NattyBoppy/MDDSTROKE/docs/design/hand_unit_layout.html

Stroke hand exoskeleton · V1 layout

# Hand Unit Layout

Where the 4 flex sensors and the 2 MG996R servos go. The flex sensors are the same in both designs. The servos either sit on the back of the hand (design A) or in a box on the table, pulling the lines through tubes (design B).

PickDesign B for V1. It keeps about 150 g of motors off a weak hand and has room for the bigger spool the MG996R needs. It also gives you a kill switch within reach, and it matches the two-piece setup your prof said he'd accept if justified.

Loading 3D model…

Design B · table-top unitDrag to rotate · scroll or pinch to zoom

Design

A · Servos on hand B · Table-top unit

Servo rotation

120° datasheet 180° wide pulse

Flex sensor length

2.2 inch 4.5 inch

TPU clamps Flex sensor Fishing line Elastic strap MG996R Coil sheath

Flex sensors · side view of one finger

## One sensor per finger, under the line, free to slide

Every clamp now has a flat 7.2 × 1.0 mm slot just above the finger and below the two line channels. The updated STLs on the clamp page include it.

Why this way

## The most workable mount

- Fix one end only. The back of the finger gets about 40 mm longer when you make a fist, but the sensor doesn't stretch. If both ends were fixed it would buckle or tear. Clamp the pin end on the plate and let the rest slide through the clamps.
- Don't bend the pin end. The makers warn the base of the sensor cracks if it flexes. The clamp on the plate keeps the first 15 mm or so dead flat.
- Closest to the finger. The slot sits under the line and strap, so the sensor follows the finger's curve and is protected from being pulled or snagged.
- Length matters. A 2.2" sensor reads mostly the big knuckle (MCP), which is the main joint in a clenched fist. A 4.5" sensor covers all three joints. Slide a 4.5" further back on the pinky so it doesn't stick out past the fingertip.
- Works with both designs. The 4 sensor cables run back along the plate to the controller.

The two motor designs

## Servos on the hand, or in a box beside it

Later, if portable matters

### A · Servos on the back of the hand

The finger servo lies on its side on a plate over the knuckles, with the spool beside it. The thumb servo doesn't fit beside it, so it sits behind, over the wrist, on a cuff. The ESP32 and battery go in a forearm pack.

Good

- No tubes, so no friction loss in the line
- Patient can walk around with it
- Simple line path

Problems

- About 170–200 g on a weak hand, as much as a phone
- Spool stands about 35–50 mm off the hand
- Spills over the wrist
- Motor noise and heat on the skin
- High-current servo wires and a battery on the arm

Recommended for V1

### B · Table-top unit with sheaths

Both servos, their spools, the ESP32-S3 DevKit and the power supply sit in a box on the table. The hand wears only the clamps, the sensors and a light plate. On the plate, the 4 finger lines meet at the balance bar (whiffletree), and the sheath ends are held in a stop block. Each line then runs to the box inside a coil sheath (Bowden cable) with a PTFE liner, like SNU's Exo-Glove.

Good

- Only about 30–40 g on the hand
- Low profile, under 15 mm
- Room for a big spool, or a stronger motor later
- Kill switch and power on the table
- Same idea as SNU's Exo-Glove

Problems

- Sheaths lose about 20–40% of the pull to friction, more with tight bends
- Tethered to the table
- Sheath ends need solid stops at both ends

What matters | A · on hand | B · table-top
Weight on the hand | ≈ 170–200 g | ≈ 30–40 g
Height above the hand | — | < 15 mm
Pull reaching the finger | All of it | About 60–80%, depending on sheath bends
Fits a clenched, spastic hand | Bulky plate is harder to strap on | Light plate, easy to strap on
Safety | Servos and battery on the body | Kill switch and supply on the table
Portable | Yes | No, it's tethered
Upgrade path | Stuck with small motors | Bigger motors fit in the box
Matches prof's brief | Portable, but heavy | Two-piece is accepted if justified

Numbers · one MG996R pulling all 4 fingers

## Spool size and pull

Going from a full fist to straight, each finger's line has to travel about 40–47 mm. That's my estimate from your finger sizes and normal joint ranges, so measure it on the test hand with a piece of string. A servo can only reel in line equal to spool radius × rotation, so less rotation needs a bigger spool, and a bigger spool pulls more weakly.

Servo rotation | Spool radius for 47 mm | Line pull at stall, 6 V | Per finger at stall | Per finger, safe running (≈ half)

One servo for 4 fingers is tight

At 120°, each finger gets only about 6 N in steady use, before any sheath losses. That may not open a strongly spastic hand. Before building the box, hang a luggage scale on one finger of the test hand and measure the pull it needs. If it's more than this, two fixes are possible. One is to set the servo to 180° by testing it with a 500–2500 µs pulse range. The other is to use both servos for the fingers (index + middle on one, ring + pinky on the other) and add the thumb with a third motor in V2.

Wiring · ESP32-S3 DevKit (pin plan from the repo)

## Pins and power

Part | GPIO | Notes
Flex sensors (index, middle, ring, little) | 4, 6, 7, 8 | 3V3 → flex → GPIO → 47k → GND. Pick the fixed resistor close to the sensor's own resistance (measure it with a multimeter). All on ADC1, which keeps working while Wi-Fi or Bluetooth is on. Thumb flex, later: GPIO 9.
EMG A (extensor), EMG B (flexor, later) | 1, 2 | Always through the 1/3 divider (3 × 47k). The red EMG board can output up to about 9 V.
Servo 1 (4 fingers), servo 2 (thumb) | 5, 16 | Signal wire only.
Kill switch | servo power line | The switch should cut servo power directly, not just tell the code to stop. The website STOP button (and the Space key) still sends s.
Servo power | Bench supply, adjustable 6.0 V | Set the current limit. Each MG996R can draw about 2.5 A when it stalls, so two need 5 A or more. Never power the servos from the ESP32. Join the grounds, and put a 470–1000 µF capacitor across the servo supply.
