NattyBoppy/MDDSTROKE/docs/concepts/A_c_clip_tunnels.png

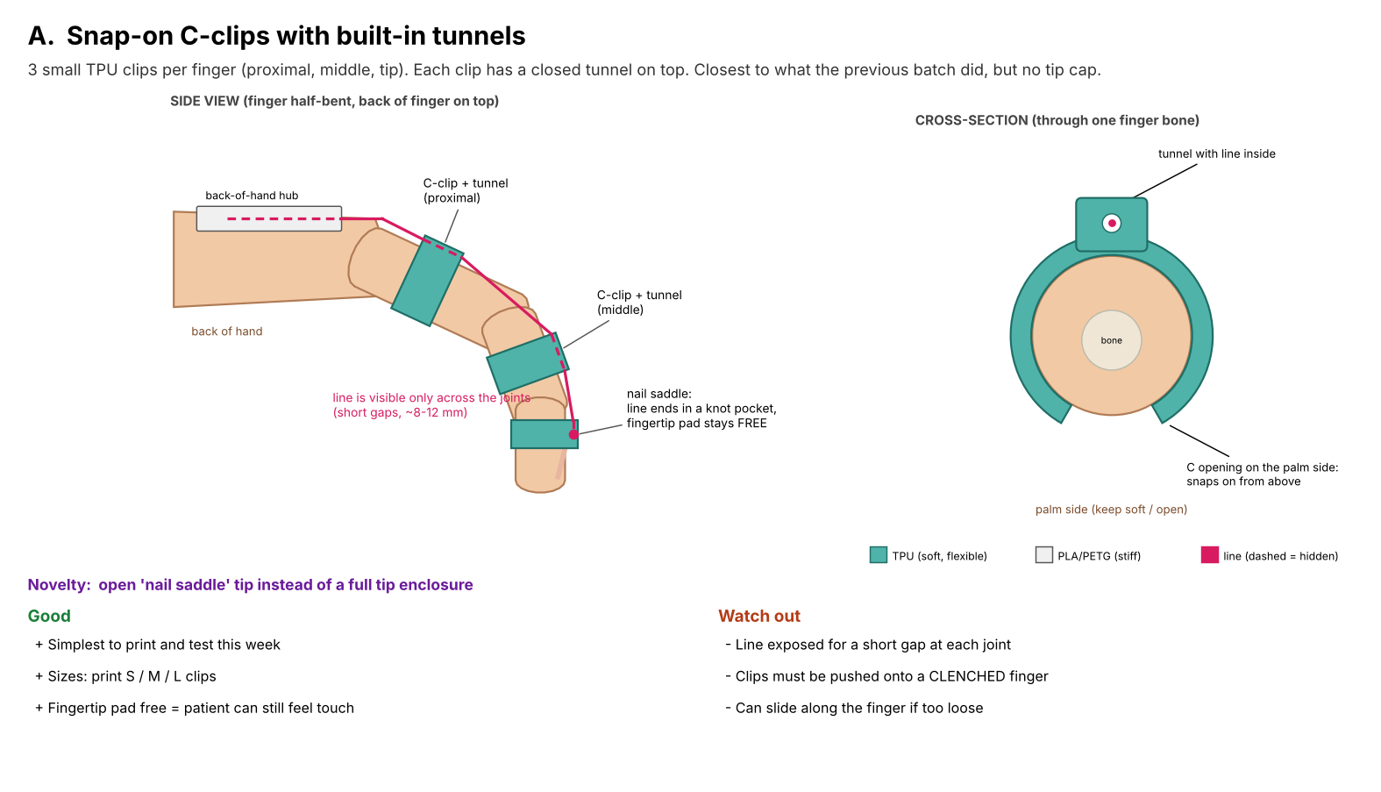
docs/concepts/A_c_clip_tunnels.png
