NattyBoppy/MDDSTROKE/docs/concepts/B_armadillo_scales.png

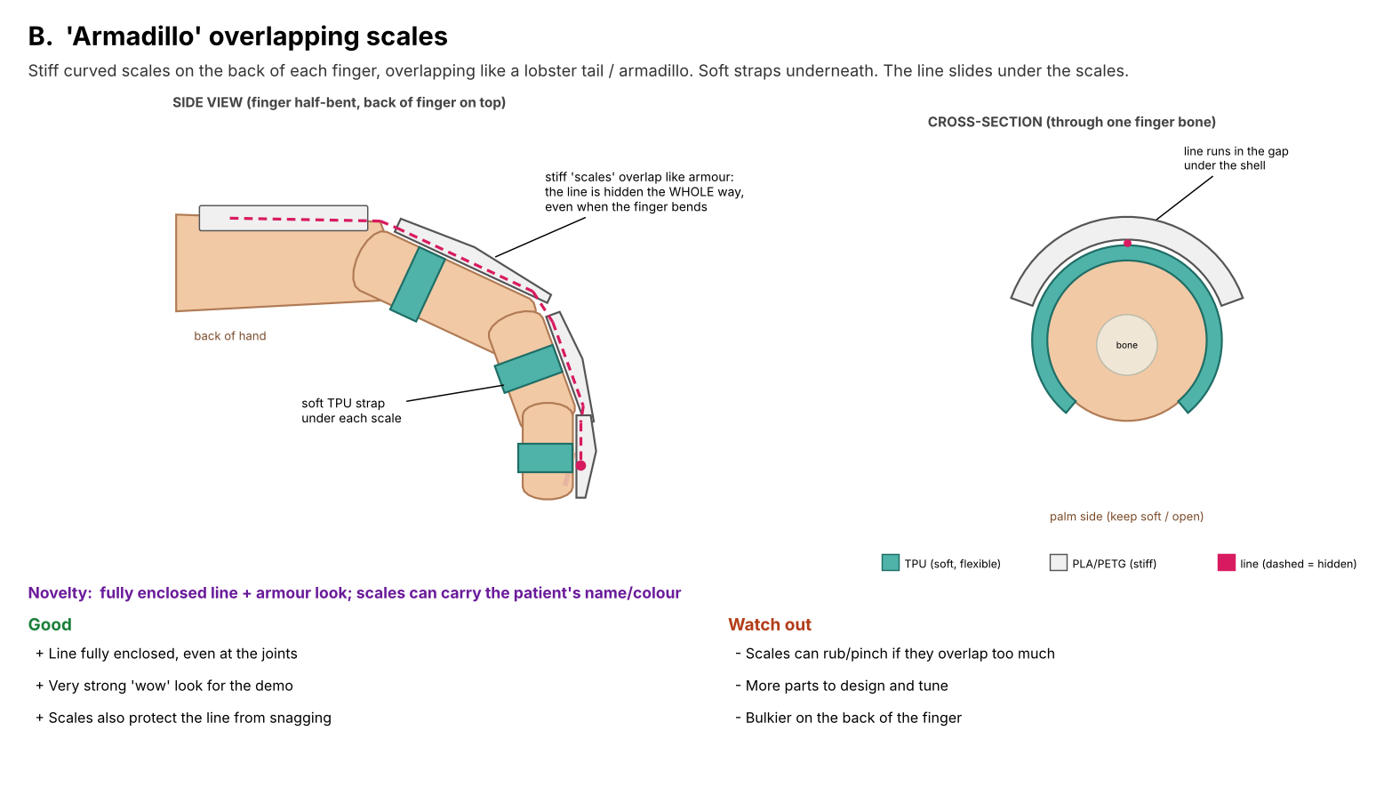
docs/concepts/B_armadillo_scales.png
