NattyBoppy/MDDSTROKE/docs/concepts/C_tpu_bellows_spine.png

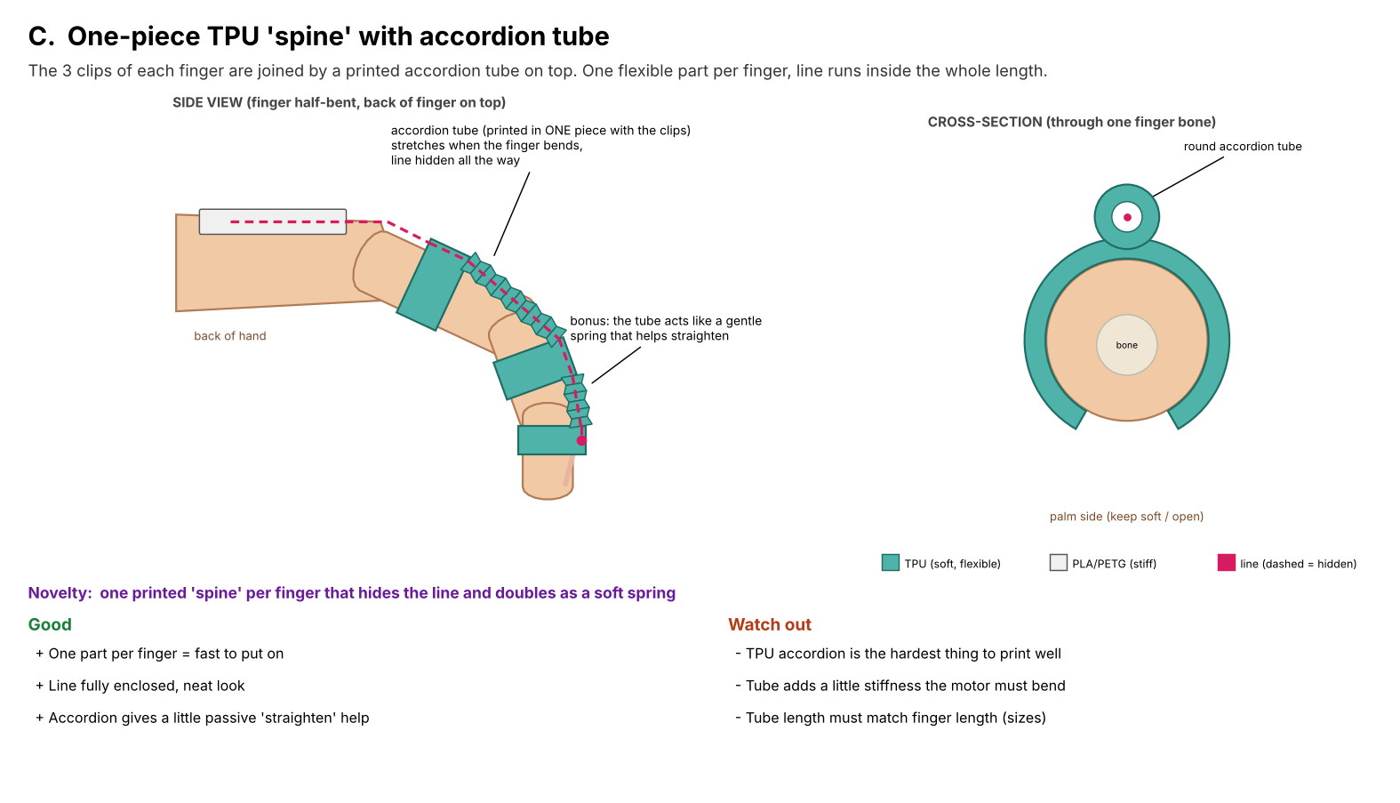
docs/concepts/C_tpu_bellows_spine.png
