NattyBoppy/MDDSTROKE/docs/concepts/D_open_tip_glove.png

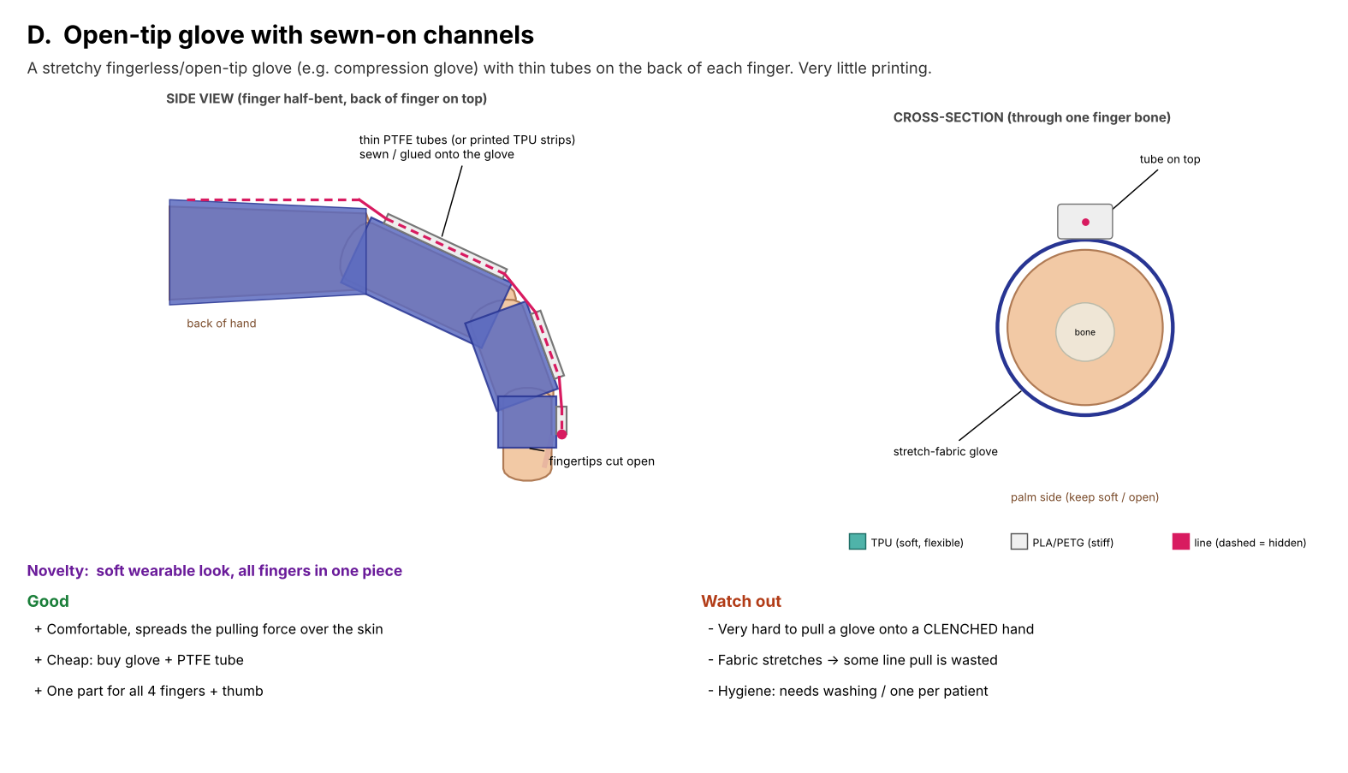
docs/concepts/D_open_tip_glove.png
