NattyBoppy/MDDSTROKE/docs/concepts/E_wrap_strap_clamp.png

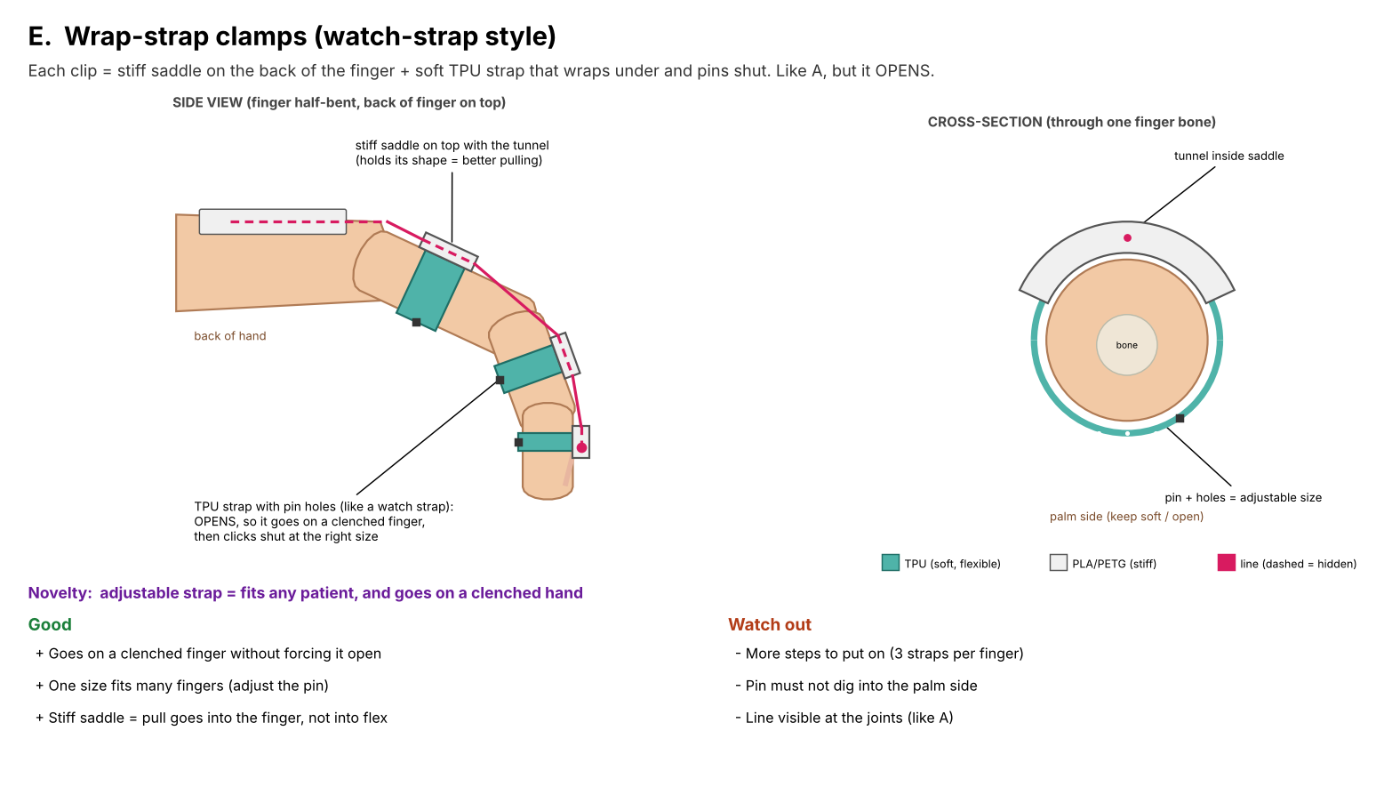
docs/concepts/E_wrap_strap_clamp.png
