NattyBoppy/MDDSTROKE/docs/concepts/glove_concepts.png

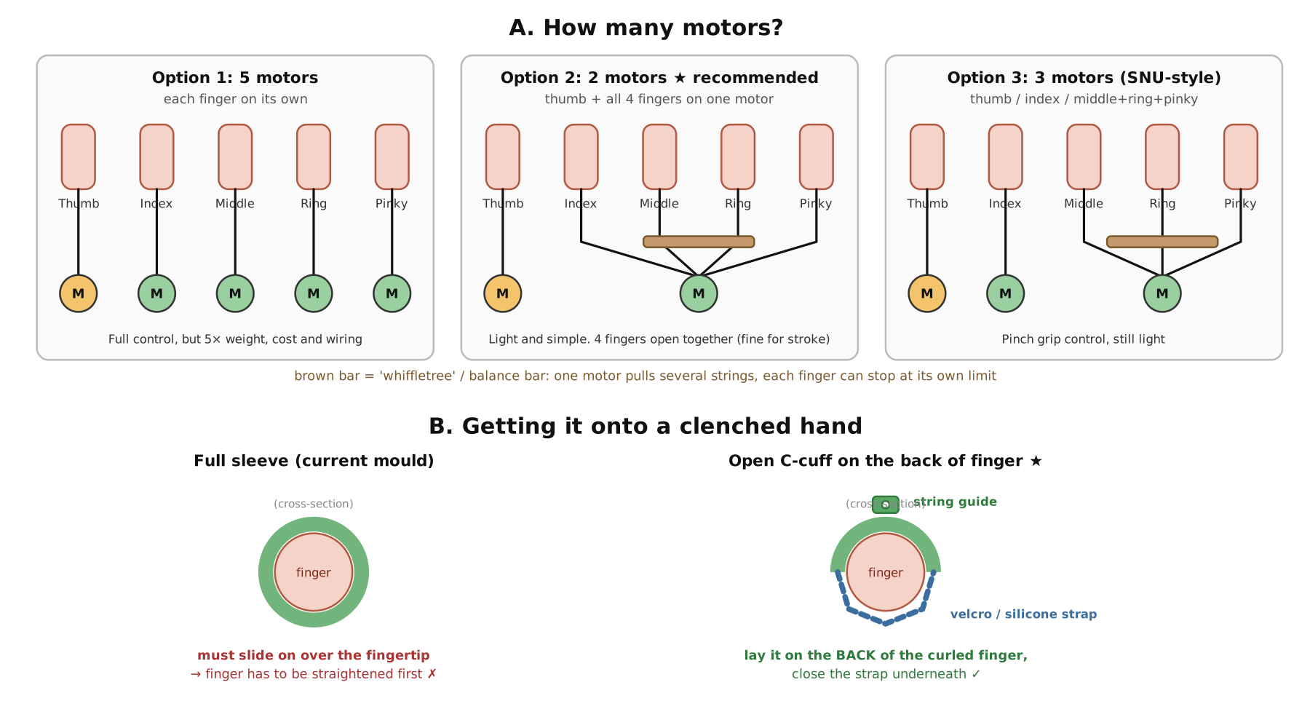
docs/concepts/glove_concepts.png
