NattyBoppy/MDDSTROKE/docs/concepts/table_unit_layout.png

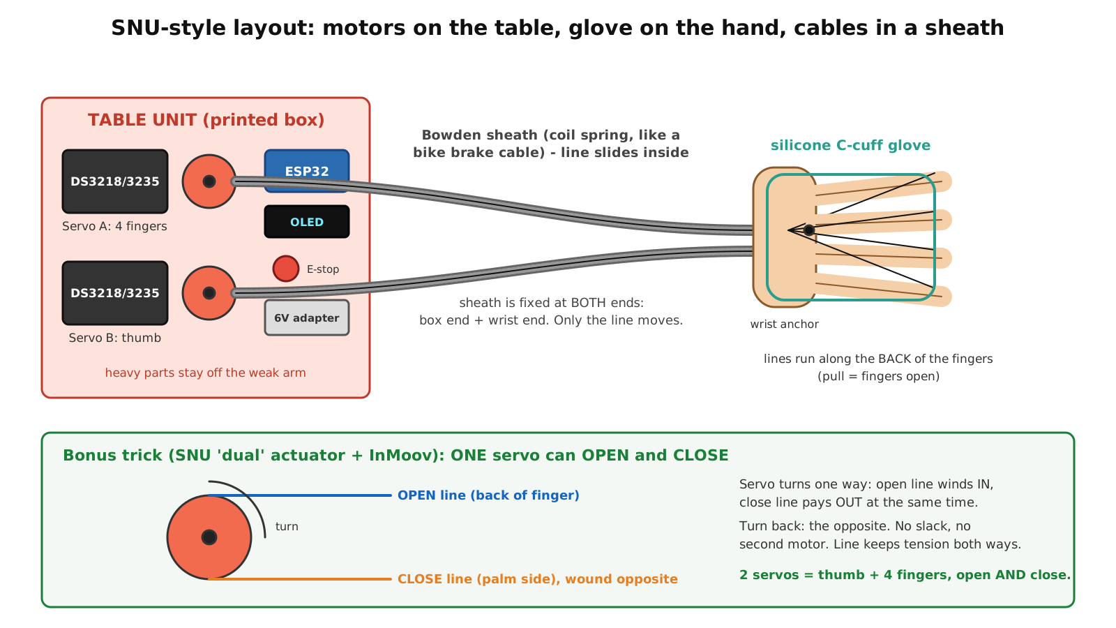
docs/concepts/table_unit_layout.png
