NattyBoppy/MDDSTROKE/docs/concepts/whiffletree.png

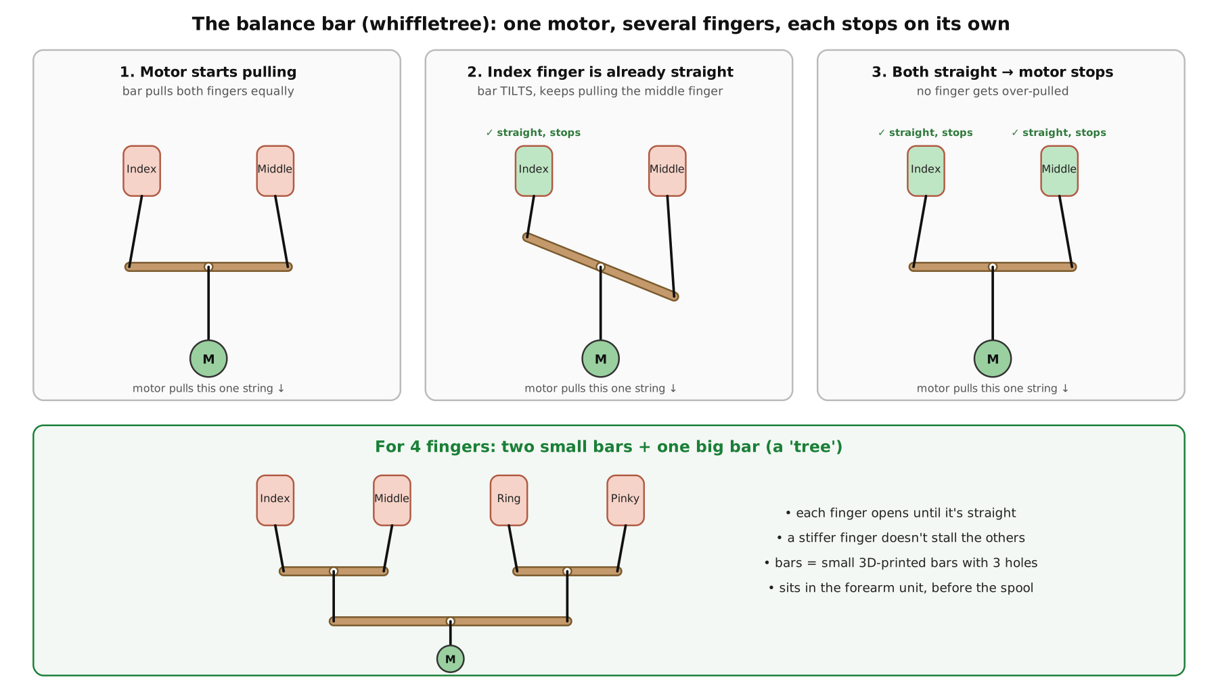
docs/concepts/whiffletree.png
