NattyBoppy/MDDSTROKE/docs/previews/anchors_snapin.png

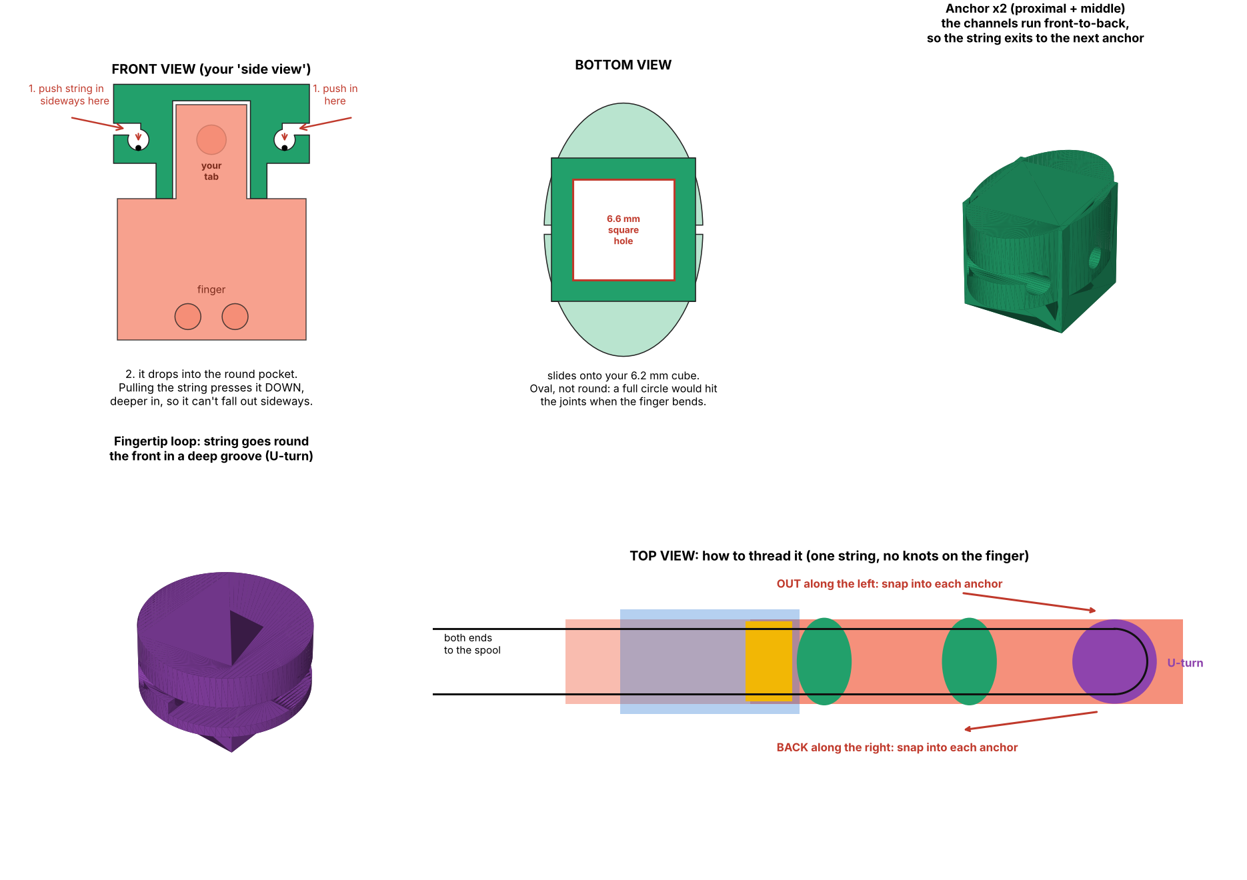
docs/previews/anchors_snapin.png
