NattyBoppy/MDDSTROKE/docs/previews/finger_clamps/tip_clamp_nose_v8.png

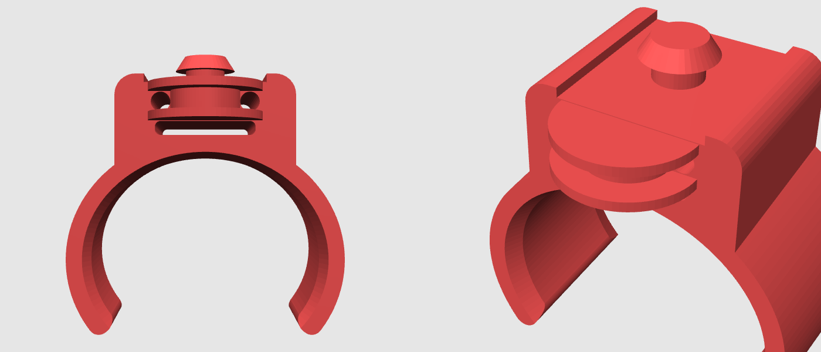
docs/previews/finger_clamps/tip_clamp_nose_v8.png
