NattyBoppy/MDDSTROKE/docs/previews/hand_mount_on_hand.png

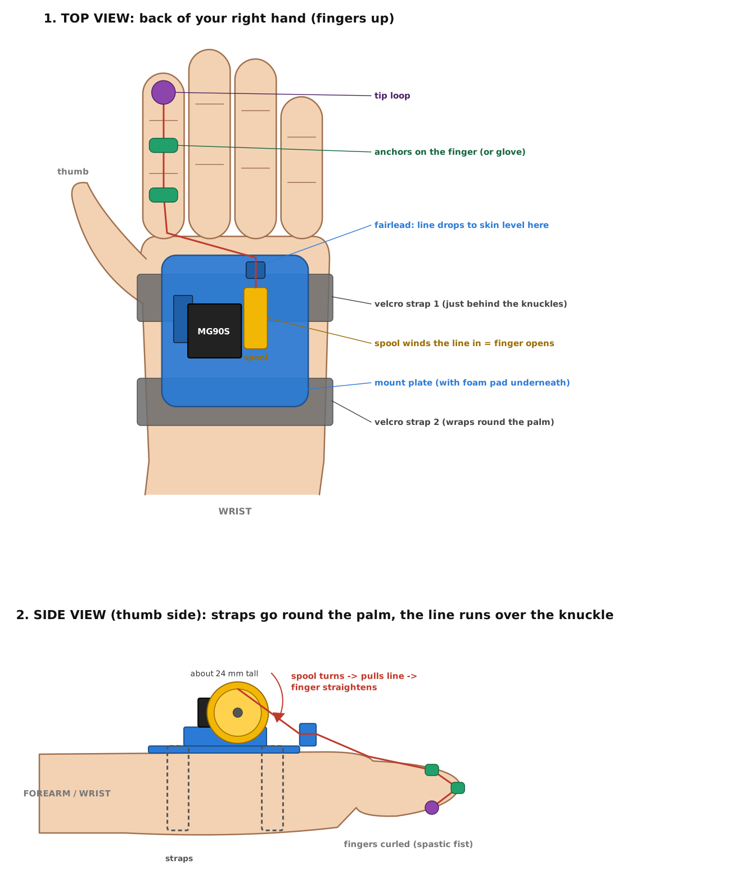
docs/previews/hand_mount_on_hand.png
