NattyBoppy/MDDSTROKE/docs/previews/knuckle_closeup.png

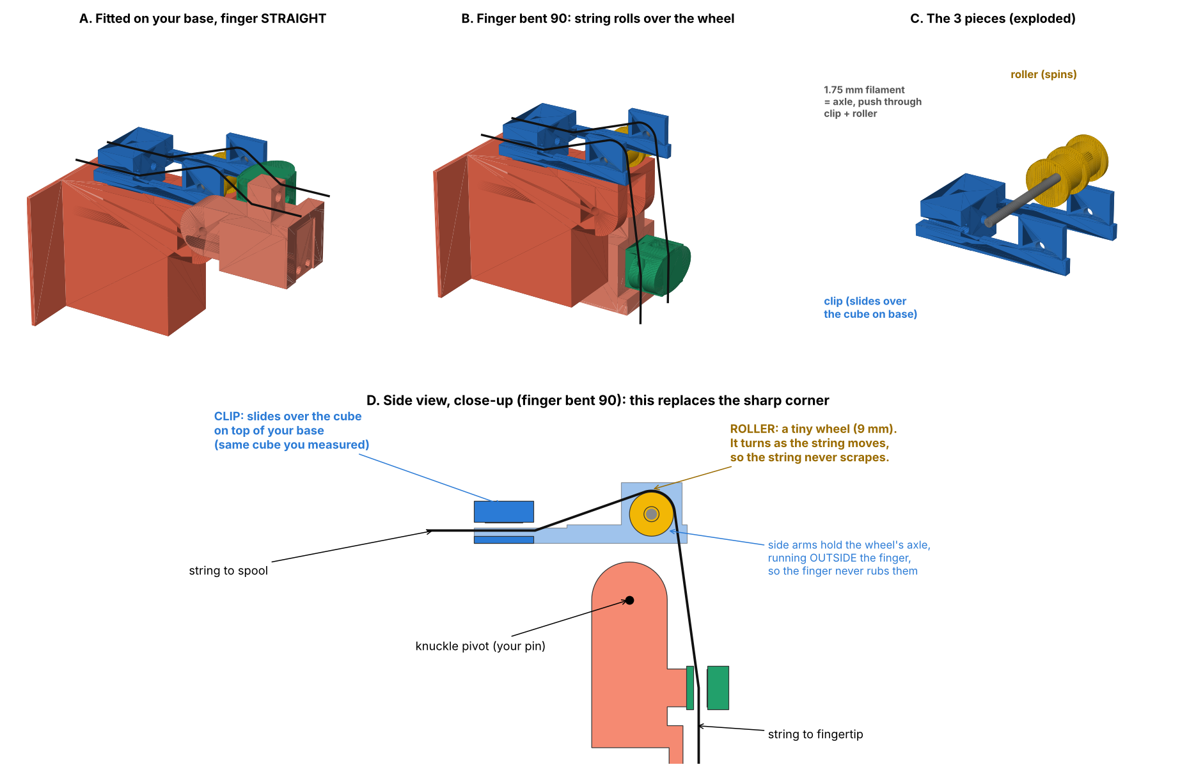
docs/previews/knuckle_closeup.png
