NattyBoppy/MDDSTROKE/docs/previews/spool_v4_preview.png

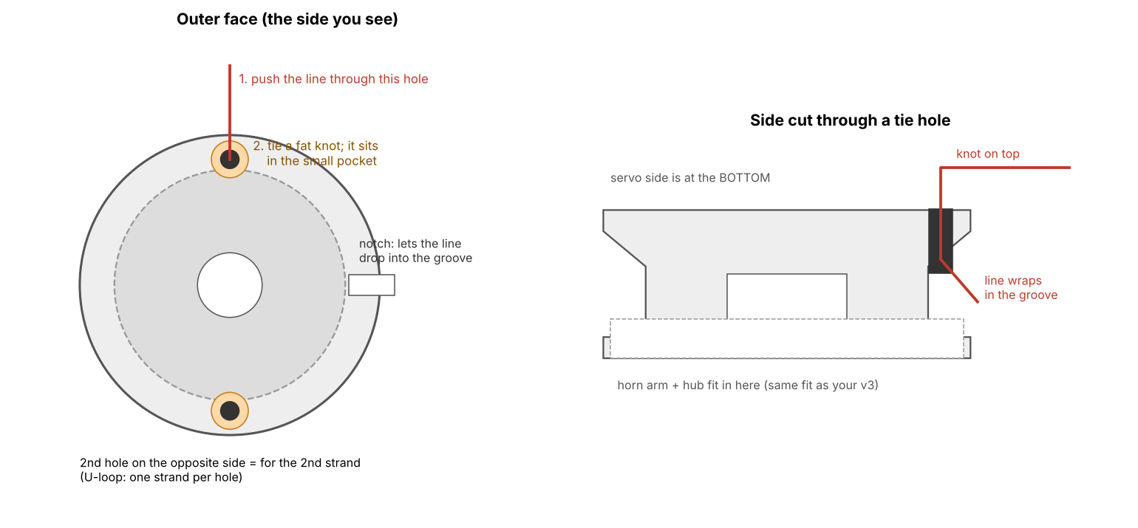
docs/previews/spool_v4_preview.png
