NattyBoppy/MDDSTROKE/docs/screenshots/desktop.png

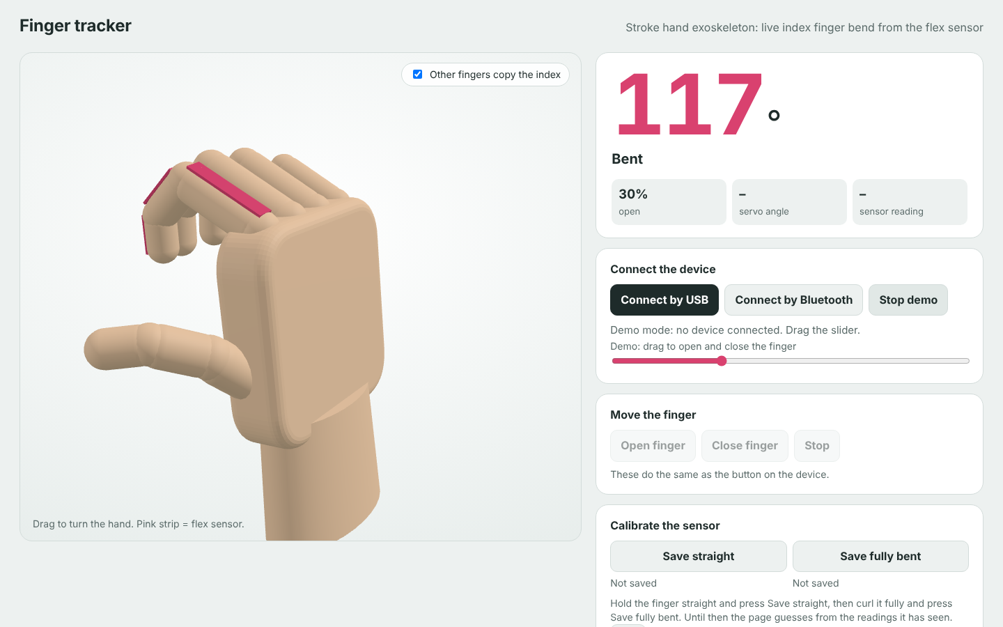
docs/screenshots/desktop.png
