NattyBoppy/MDDSTROKE/docs/screenshots/phone.png

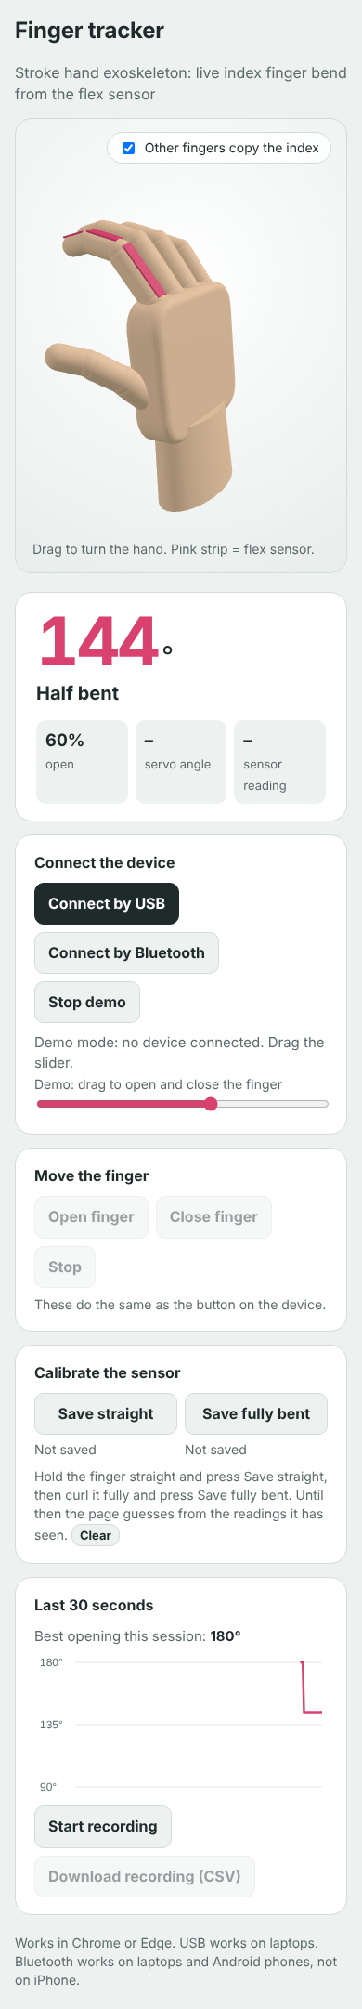
docs/screenshots/phone.png
