NattyBoppy/MDDSTROKE/docs/screenshots/v2_blocked.png

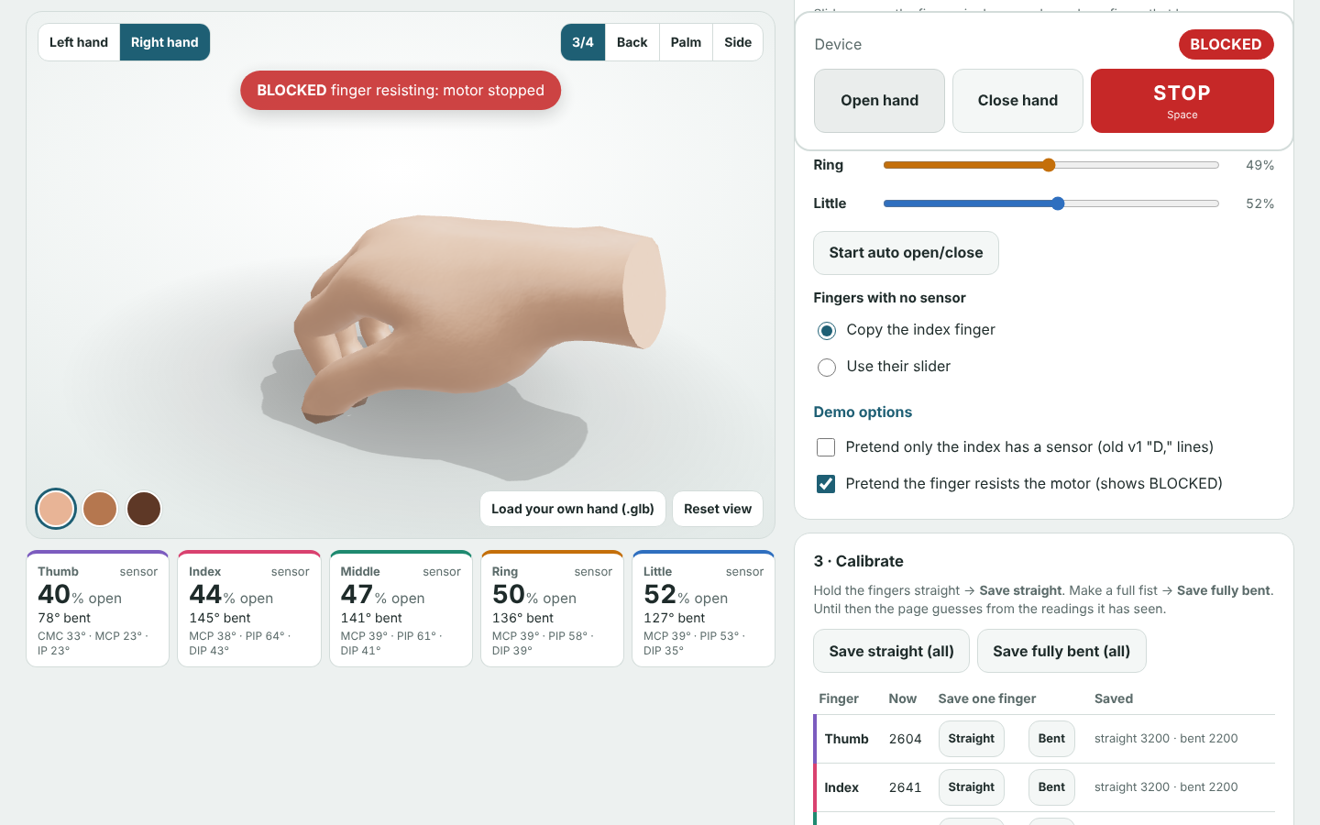
docs/screenshots/v2_blocked.png
