NattyBoppy/MDDSTROKE/docs/screenshots/v2_desktop_dark.png

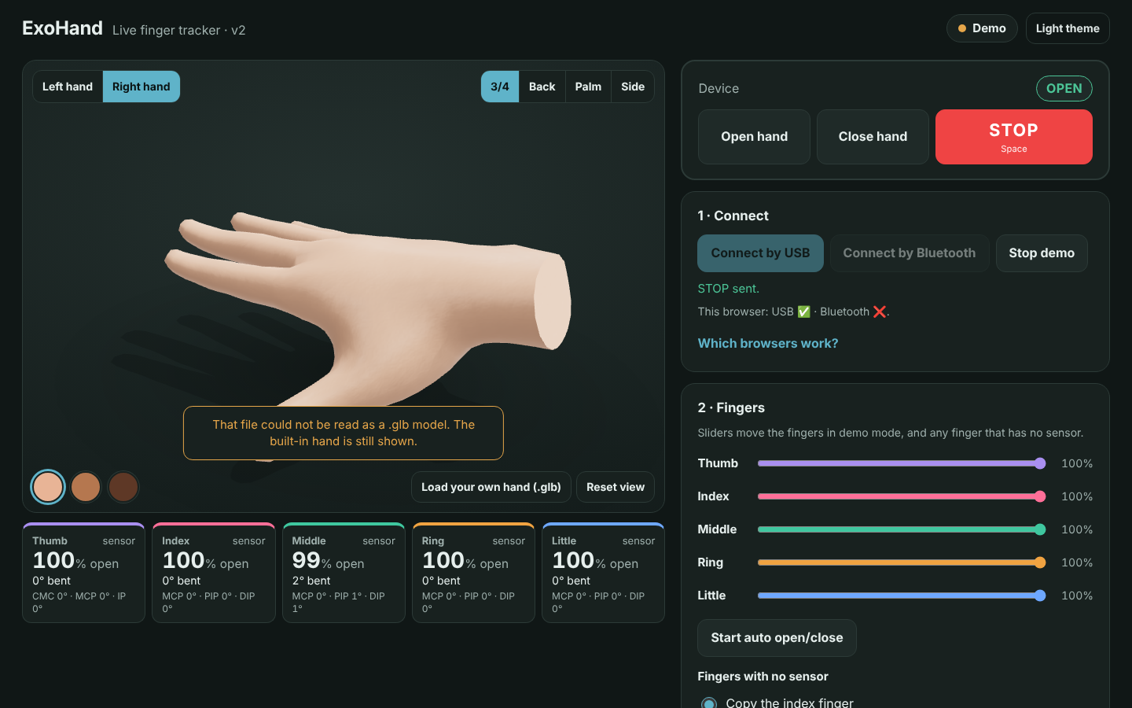
docs/screenshots/v2_desktop_dark.png
