NattyBoppy/MDDSTROKE/docs/screenshots/v2_desktop_open.png

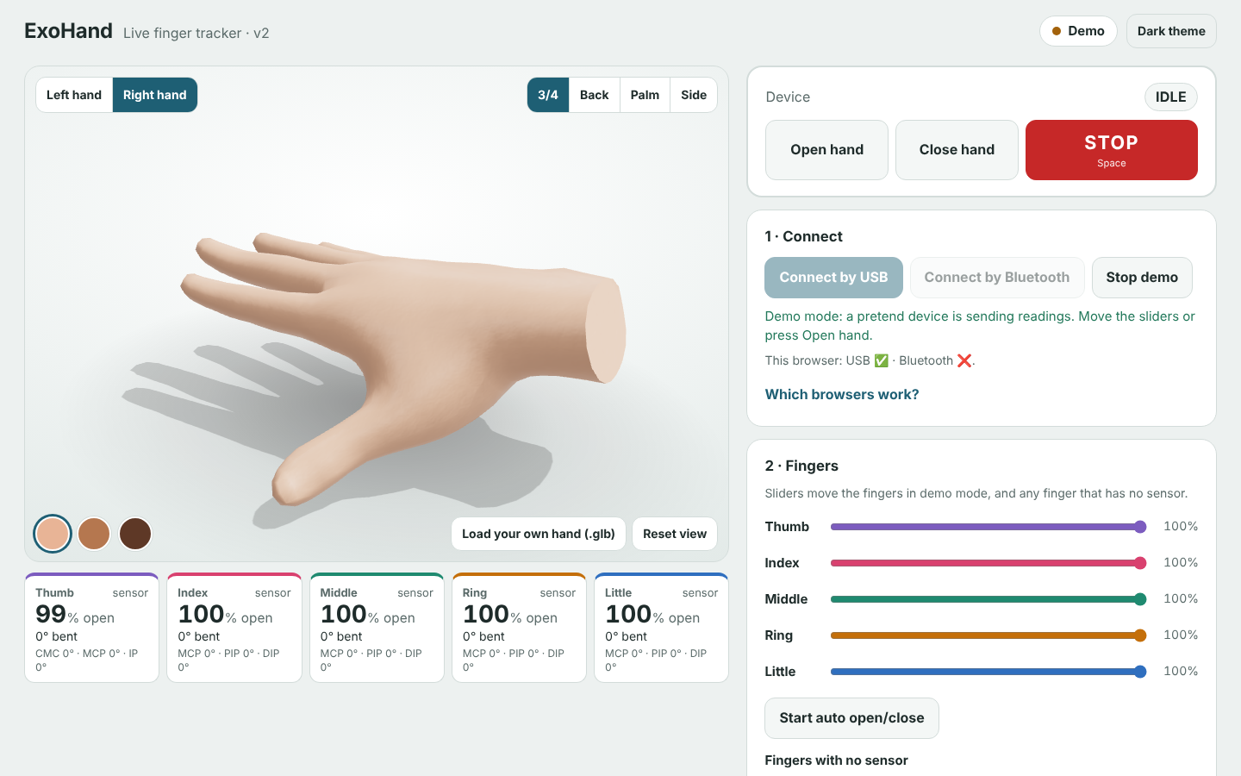
docs/screenshots/v2_desktop_open.png
