NattyBoppy/MDDSTROKE/docs/screenshots/v2_phone.png

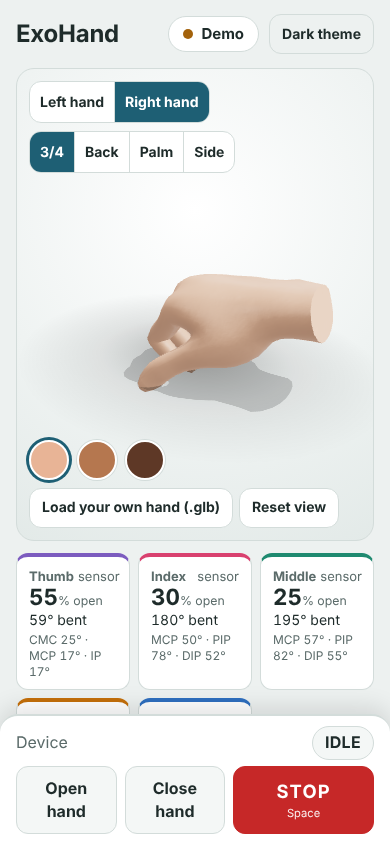
docs/screenshots/v2_phone.png
