NattyBoppy/MDDSTROKE/hardware/stl/spool_v4/spool_v4_r15_full_horn.stl

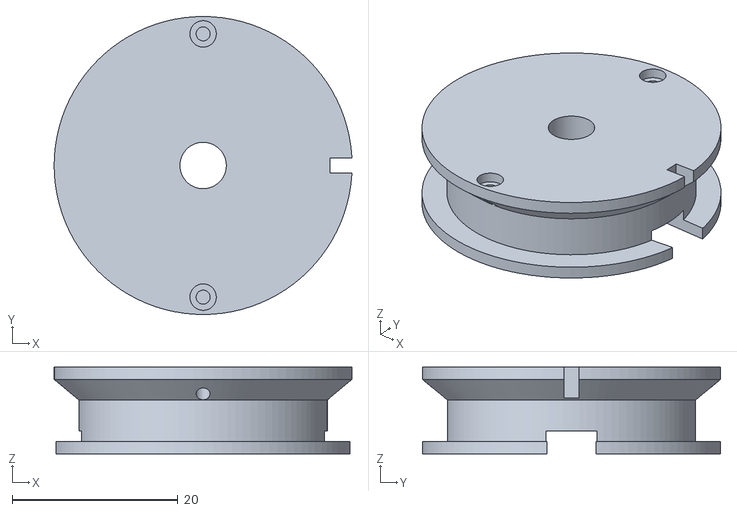
[picture p27: CAD file, 2026-10-20]
hardware/stl/spool_v4/spool_v4_r15_full_horn.stl
36.0 x 36.0 x 10.5
