NattyBoppy/MDDSTROKE/hardware/stl/finger_clamps_v8/index_2_middle_v8.stl

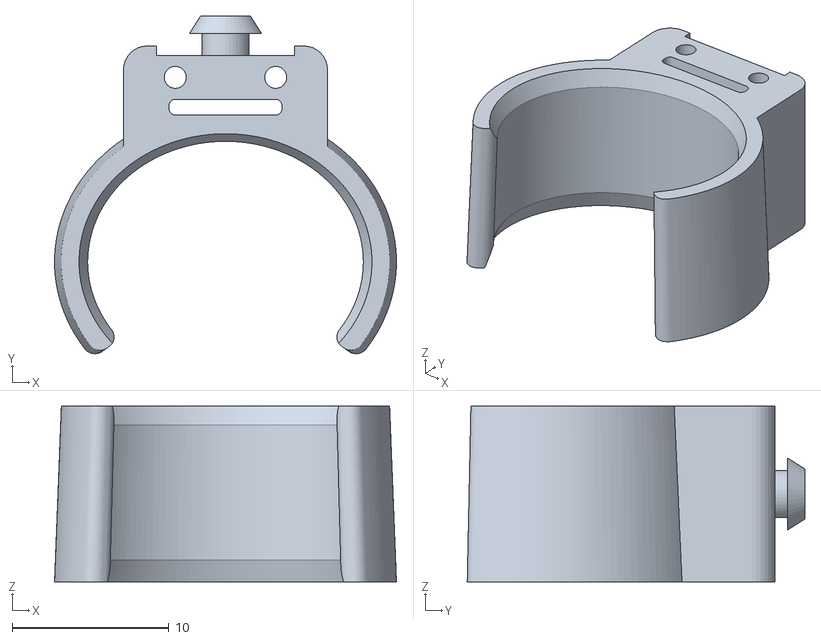
[picture p28: CAD file, 2026-10-23]
hardware/stl/finger_clamps_v8/index_2_middle_v8.stl
21.8 x 21.5 x 11.2
