NattyBoppy/MDDSTROKE/hardware/stl/hand_mount/spool_r10_mg90s.stl

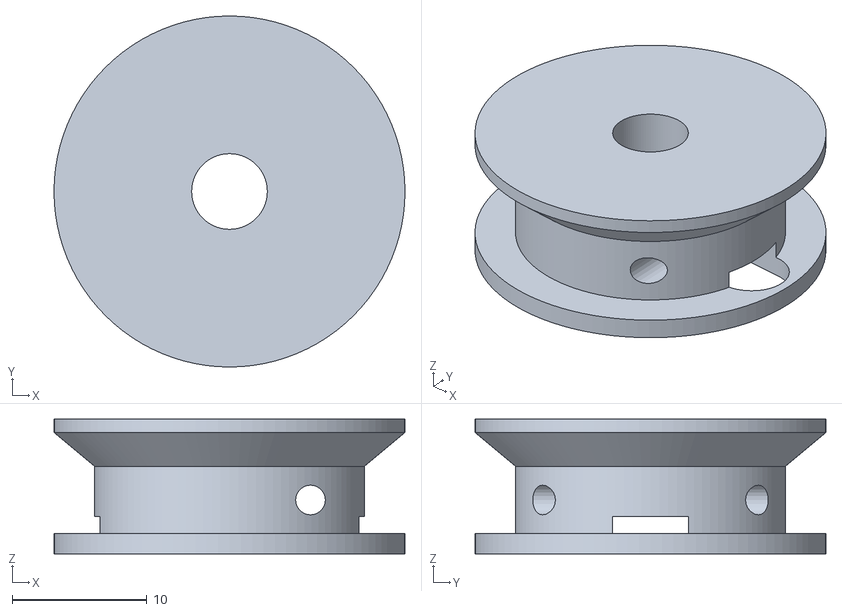
[picture p29: CAD file, 2026-10-20]
hardware/stl/hand_mount/spool_r10_mg90s.stl
26.0 x 26.0 x 10.0
