NattyBoppy/MDDSTROKE/hardware/stl/knuckle_anchor_set/anchor_middle.stl

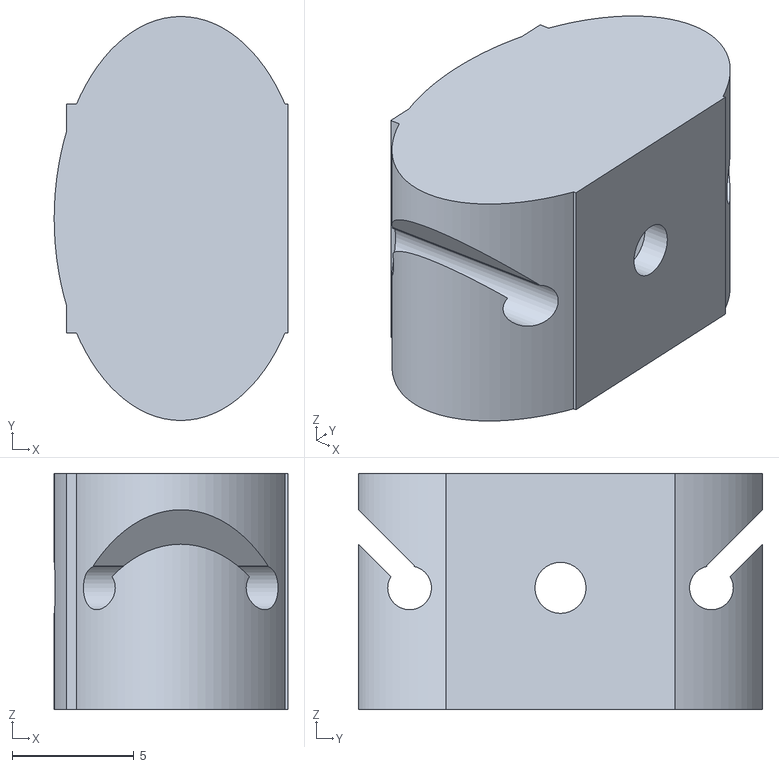
[picture p30: CAD file, 2026-10-20]
hardware/stl/knuckle_anchor_set/anchor_middle.stl
9.60 x 16.6 x 9.70
