NattyBoppy/MDDSTROKE/hardware/stl/finger_clamps_v8/middle_1_base_v8.stl

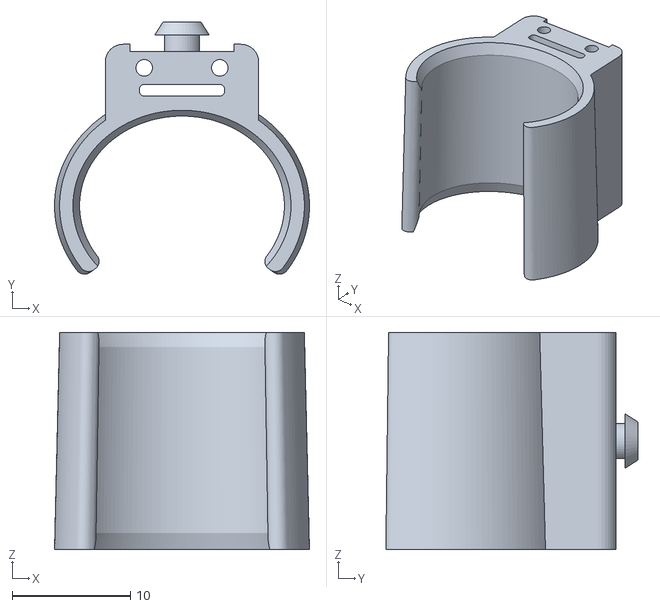
[picture p31: CAD file, 2026-10-23]
hardware/stl/finger_clamps_v8/middle_1_base_v8.stl
21.6 x 21.4 x 18.4
