NattyBoppy/MDDSTROKE/hardware/stl/hand_mount/hand_servo_mount.stl

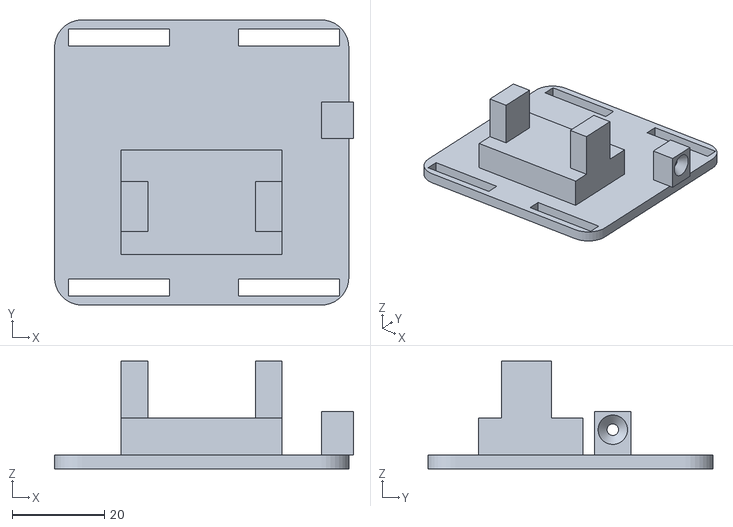
[picture p32: CAD file, 2026-10-20]
hardware/stl/hand_mount/hand_servo_mount.stl
65.0 x 62.0 x 23.4
