NattyBoppy/MDDSTROKE/hardware/stl/knuckle_anchor_set/knuckle_roller.stl

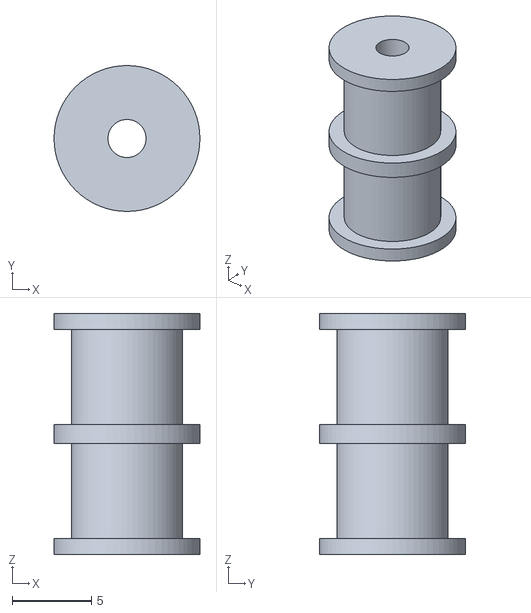
[picture p33: CAD file, 2026-10-20]
hardware/stl/knuckle_anchor_set/knuckle_roller.stl
9.20 x 9.20 x 15.2
