NattyBoppy/MDDSTROKE/hardware/stl/finger_clamps_v8/pinky_2_middle_v8.stl

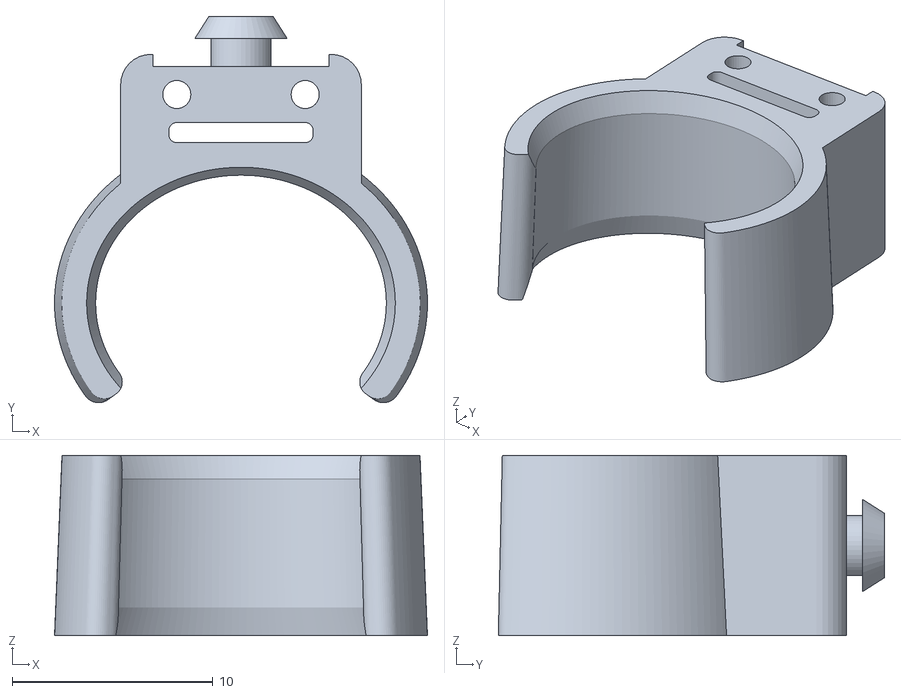
[picture p34: CAD file, 2026-10-23]
hardware/stl/finger_clamps_v8/pinky_2_middle_v8.stl
18.6 x 19.3 x 9.00
