NattyBoppy/MDDSTROKE/hardware/stl/knuckle_anchor_set/knuckle_clip.stl

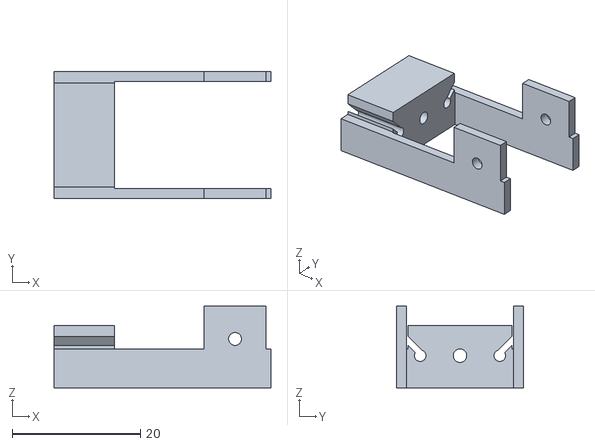
[picture p35: CAD file, 2026-10-20]
hardware/stl/knuckle_anchor_set/knuckle_clip.stl
33.8 x 19.8 x 12.7
