NattyBoppy/MDDSTROKE/hardware/stl/finger_clamps_v8/index_3_tip_v8.stl

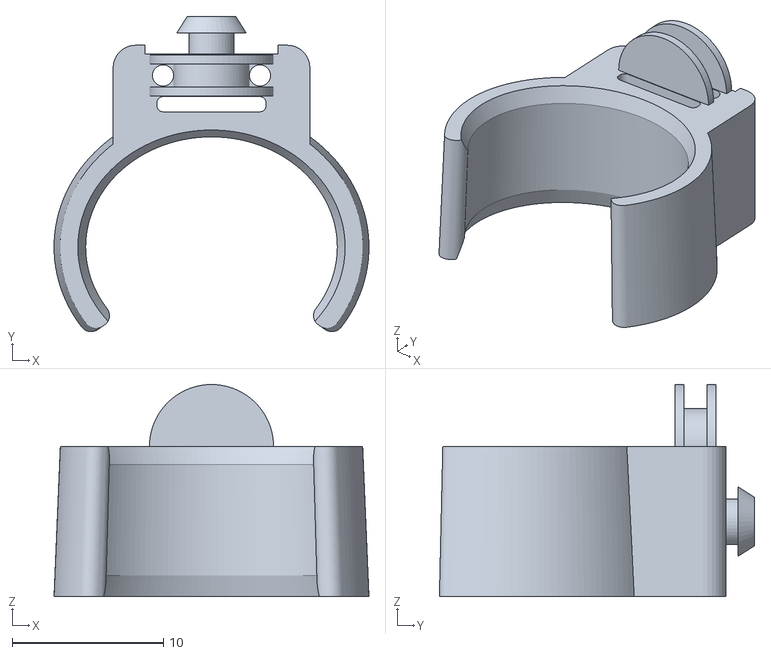
[picture p36: CAD file, 2026-10-23]
hardware/stl/finger_clamps_v8/index_3_tip_v8.stl
20.8 x 20.8 x 14.0
