NattyBoppy/MDDSTROKE/hardware/stl/knuckle_anchor_set/anchor_proximal.stl

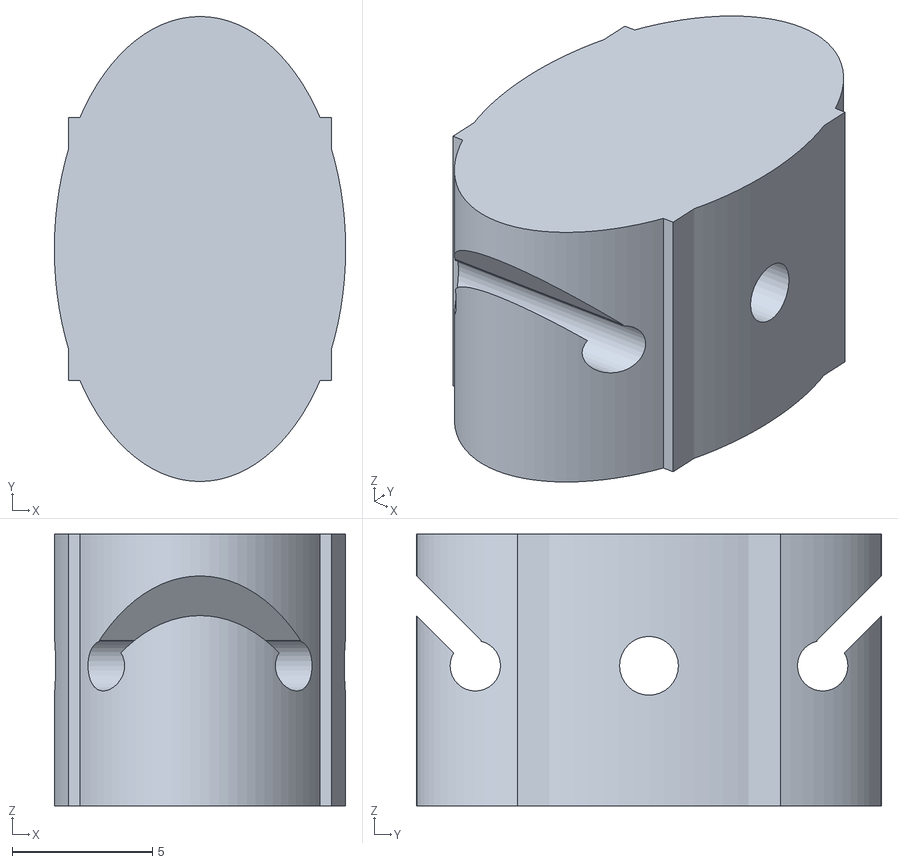
[picture p37: CAD file, 2026-10-20]
hardware/stl/knuckle_anchor_set/anchor_proximal.stl
10.4 x 16.6 x 9.70
