NattyBoppy/MDDSTROKE/hardware/stl/finger_clamps_v8/middle_2_middle_v8.stl

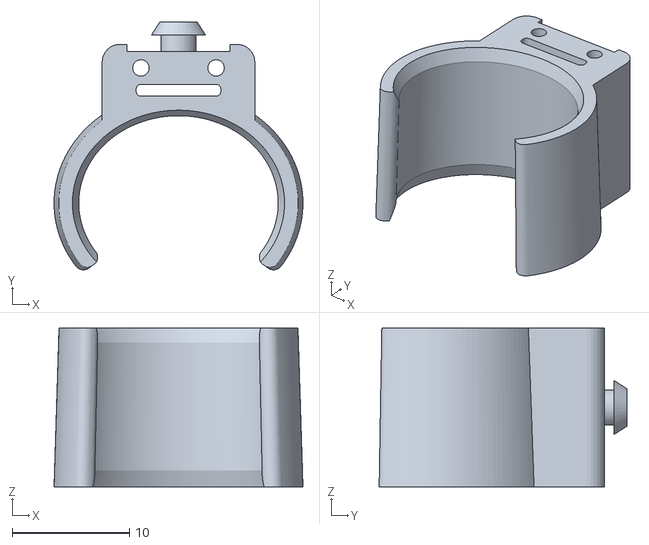
[picture p38: CAD file, 2026-10-23]
hardware/stl/finger_clamps_v8/middle_2_middle_v8.stl
21.2 x 21.1 x 13.5
