NattyBoppy/MDDSTROKE/hardware/stl/knuckle_anchor_set/tip_loop.stl

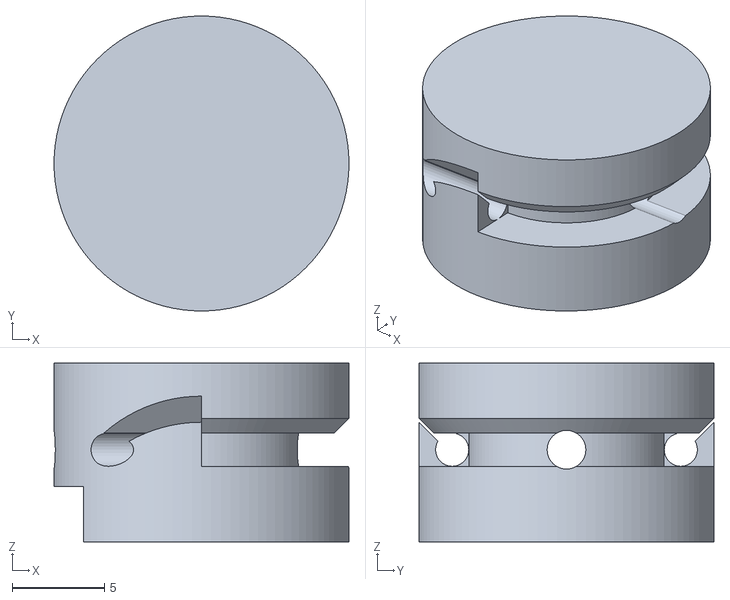
[picture p39: CAD file, 2026-10-20]
hardware/stl/knuckle_anchor_set/tip_loop.stl
16.0 x 16.0 x 9.70
