NattyBoppy/MDDSTROKE/hardware/stl/finger_clamps_v8/pinky_3_tip_v8.stl

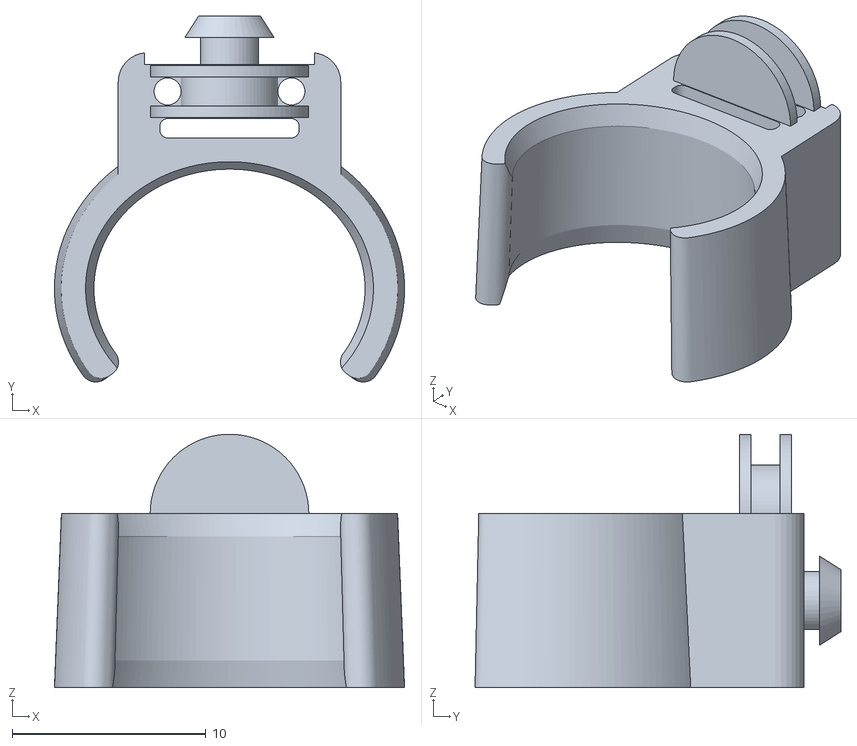
[picture p40: CAD file, 2026-10-23]
hardware/stl/finger_clamps_v8/pinky_3_tip_v8.stl
18.1 x 18.9 x 13.1
