NattyBoppy/MDDSTROKE/hardware/stl/knuckle_anchor_set/knuckle_anchor_set_plate.stl

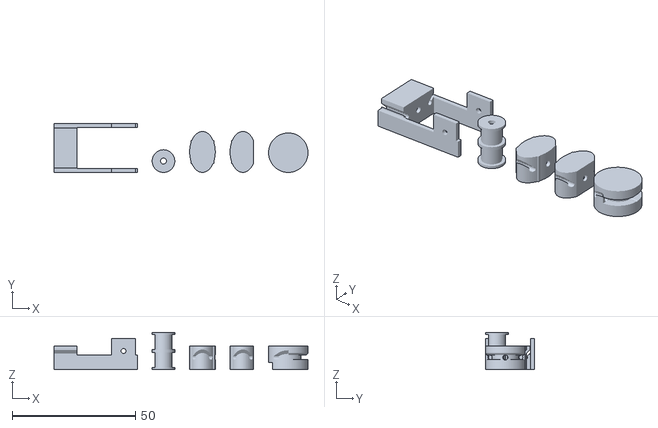
[picture p41: CAD file, 2026-10-20]
hardware/stl/knuckle_anchor_set/knuckle_anchor_set_plate.stl
103.0 x 19.8 x 15.2
