NattyBoppy/MDDSTROKE/hardware/stl/finger_clamps_v8/ring_3_tip_v8.stl

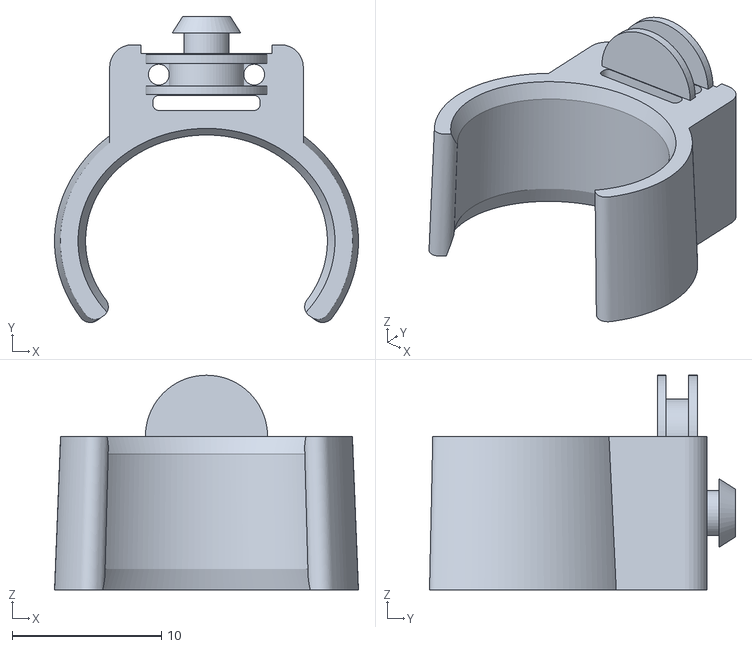
[picture p42: CAD file, 2026-10-23]
hardware/stl/finger_clamps_v8/ring_3_tip_v8.stl
20.4 x 20.5 x 14.4
