NattyBoppy/MDDSTROKE/hardware/stl/finger_clamps_v8/ring_1_base_v8.stl

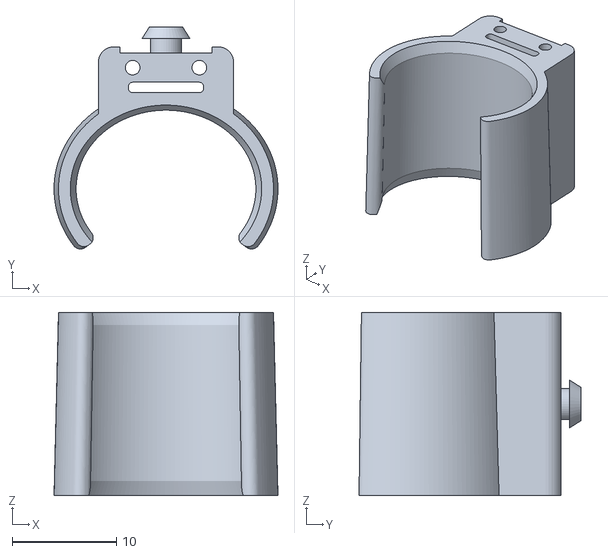
[picture p43: CAD file, 2026-10-23]
hardware/stl/finger_clamps_v8/ring_1_base_v8.stl
21.5 x 21.3 x 17.6
