NattyBoppy/MDDSTROKE/hardware/stl/finger_clamps_v8/ALL_12_print_plate_v8.stl

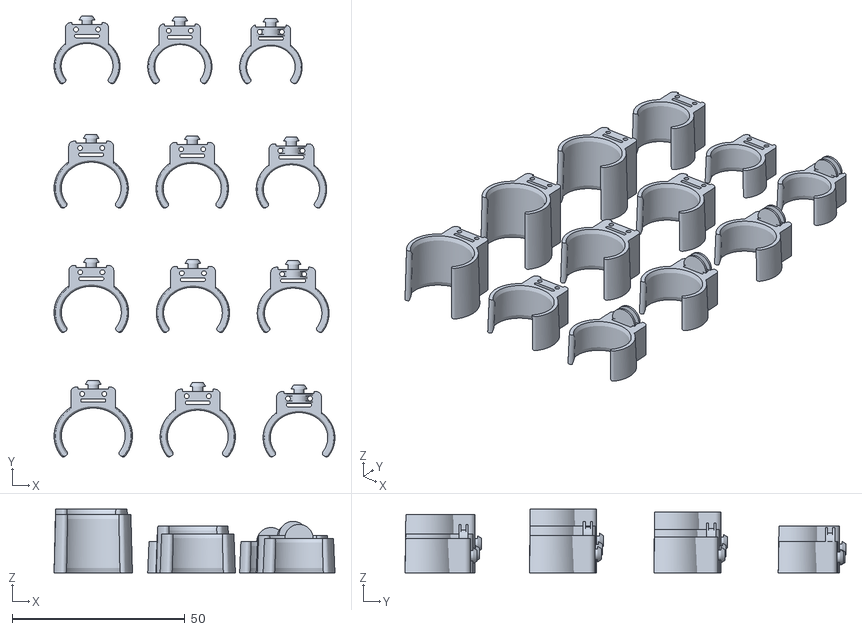
[picture p44: CAD file, 2026-10-23]
hardware/stl/finger_clamps_v8/ALL_12_print_plate_v8.stl
81.3 x 127.6 x 18.4
