NattyBoppy/MDDSTROKE/hardware/stl/finger_clamps_v8/ring_2_middle_v8.stl

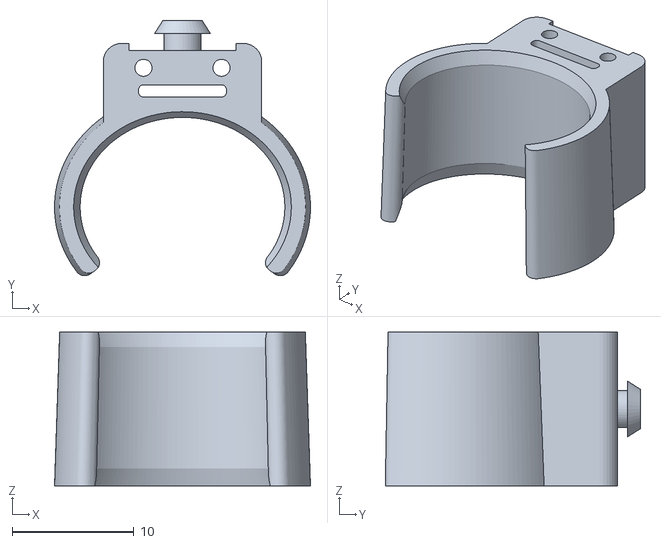
[picture p45: CAD file, 2026-10-23]
hardware/stl/finger_clamps_v8/ring_2_middle_v8.stl
21.0 x 21.0 x 12.6
