NattyBoppy/MDDSTROKE/hardware/stl/finger_clamps_v8/pinky_1_base_v8.stl

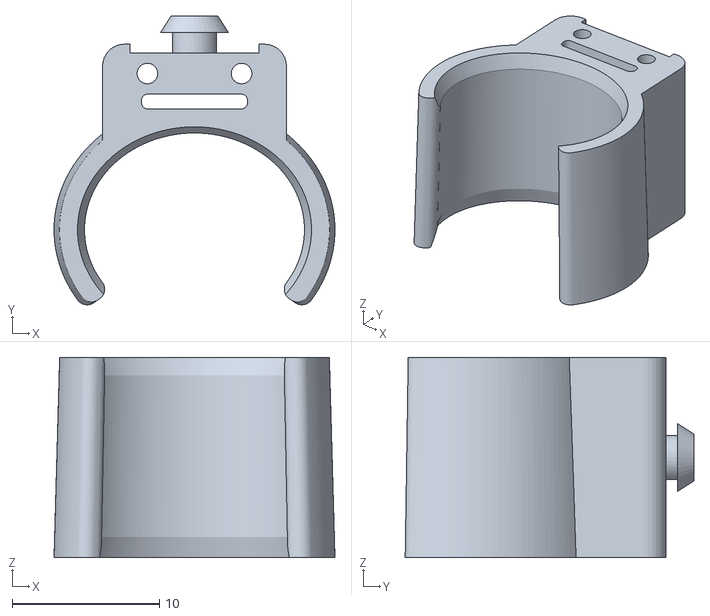
[picture p46: CAD file, 2026-10-23]
hardware/stl/finger_clamps_v8/pinky_1_base_v8.stl
19.1 x 19.6 x 13.6
