NattyBoppy/MDDSTROKE/hardware/stl/finger_clamps_v8/index_1_base_v8.stl

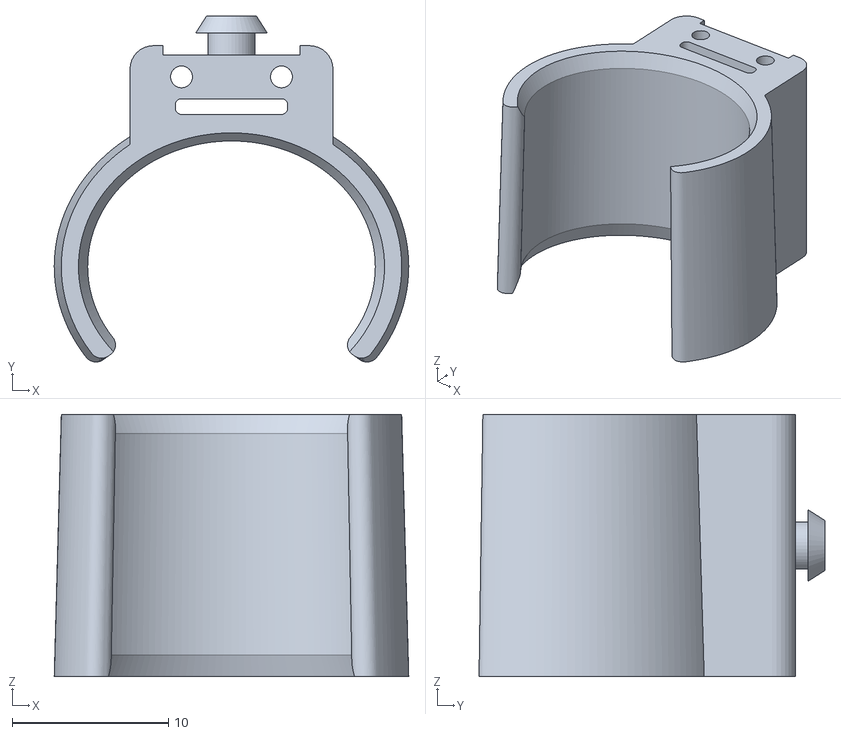
[picture p47: CAD file, 2026-10-23]
hardware/stl/finger_clamps_v8/index_1_base_v8.stl
22.7 x 22.2 x 16.8
