NattyBoppy/MDDSTROKE/(list of files, cad)

Other CAD files:
hardware/stl/spool_v4/spool_v4_r10_for_hand_mount_trim_horn.stl
