NattyBoppy/MDDSTROKE/docs/previews/print_plate_preview.png

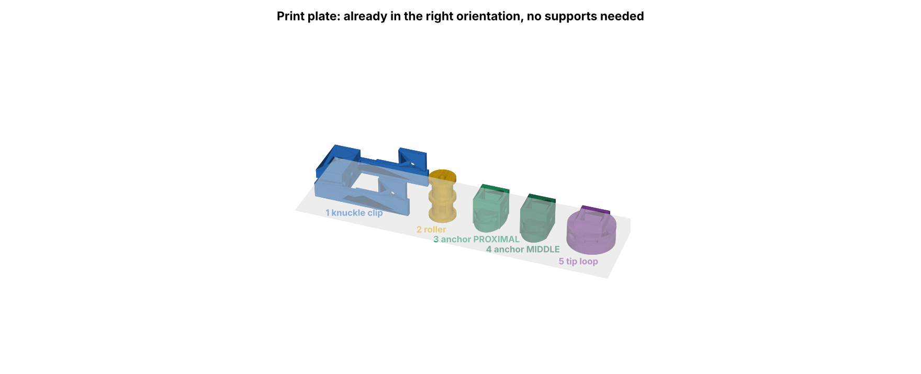
docs/previews/print_plate_preview.png
