NattyBoppy/MDDSTROKE/docs/wiring/emg_clean_wiring.png

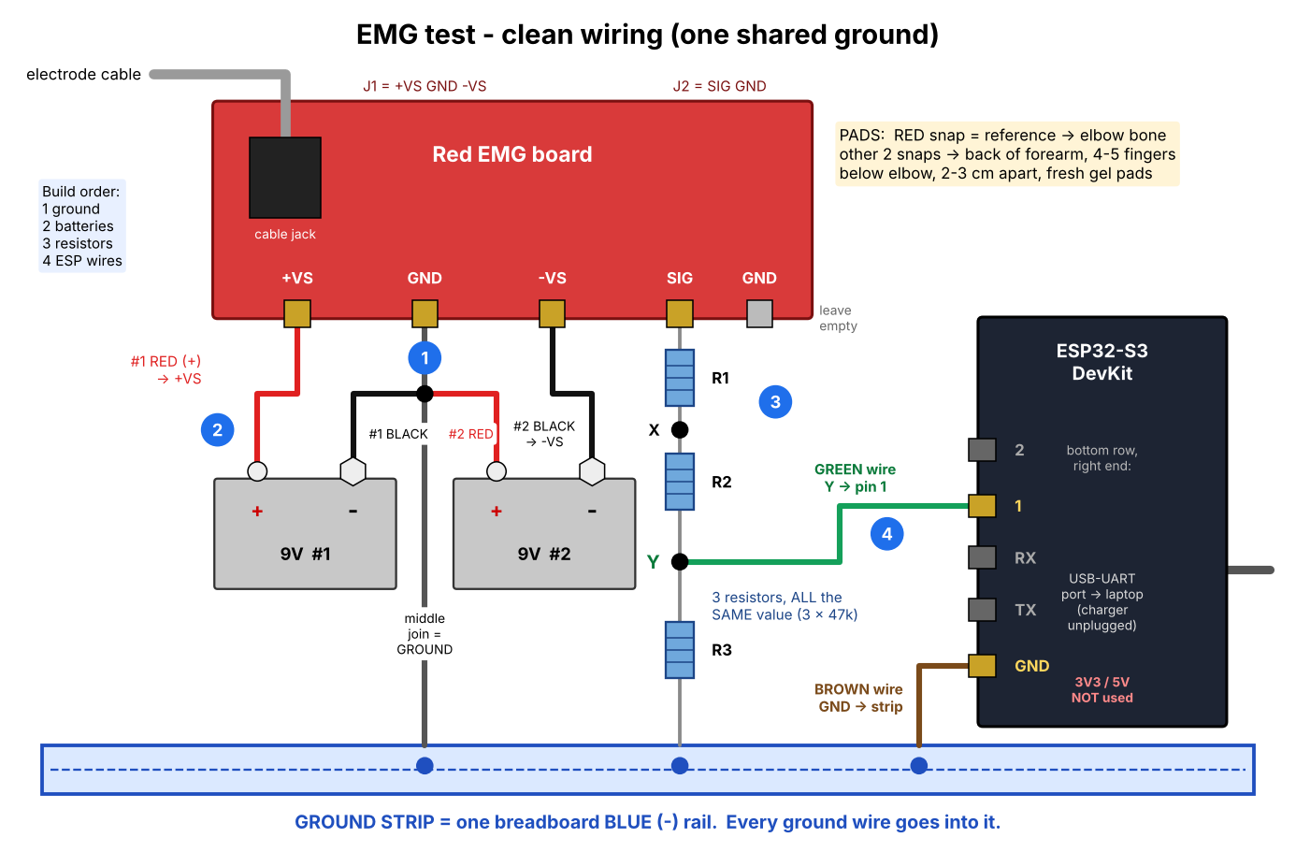
docs/wiring/emg_clean_wiring.png
