NattyBoppy/MDDSTROKE/docs/wiring/emg_placement.png

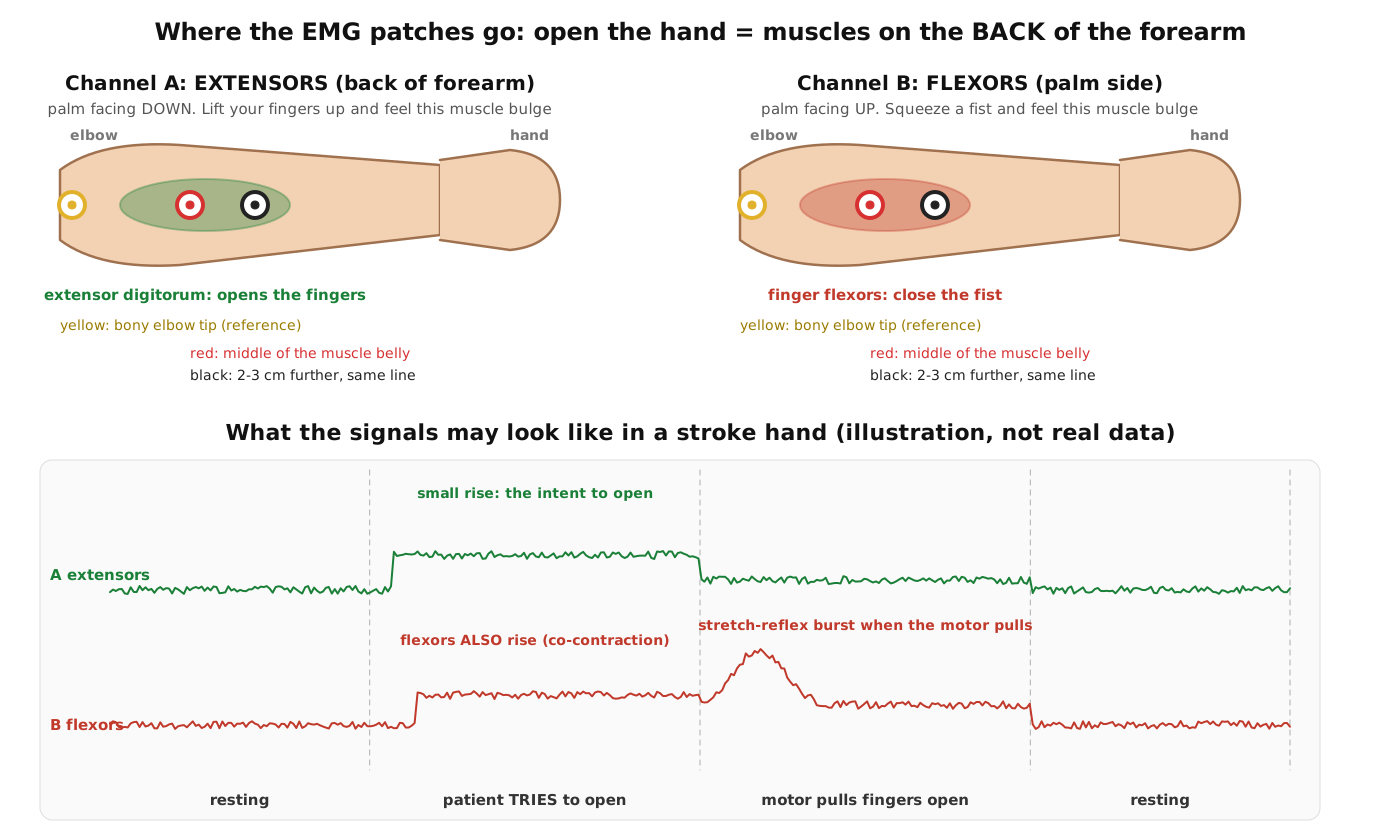
docs/wiring/emg_placement.png
