NattyBoppy/MDDSTROKE/docs/wiring/flex_5led_esp32_wiring.png

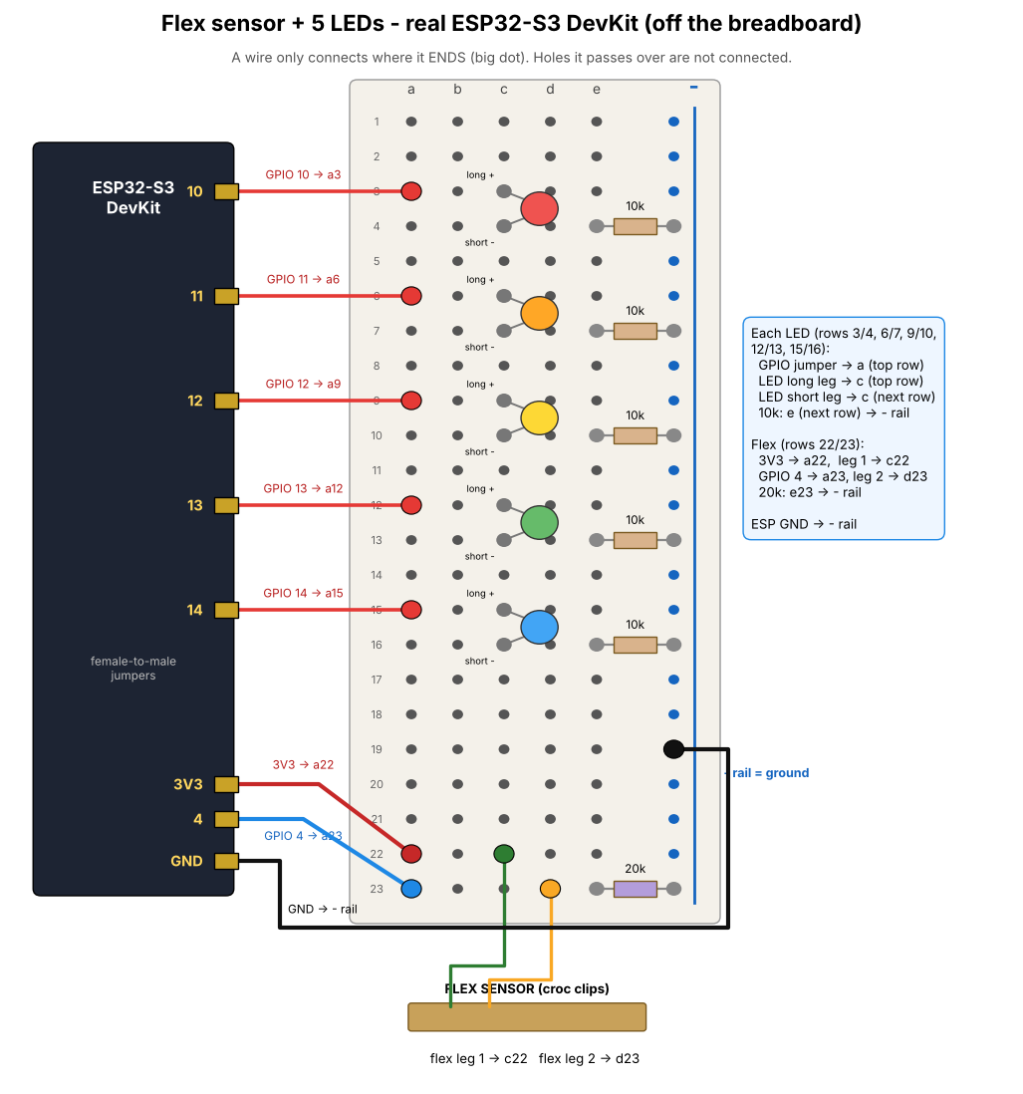
docs/wiring/flex_5led_esp32_wiring.png
