NattyBoppy/MDDSTROKE/docs/wiring/flex_control_loop.png

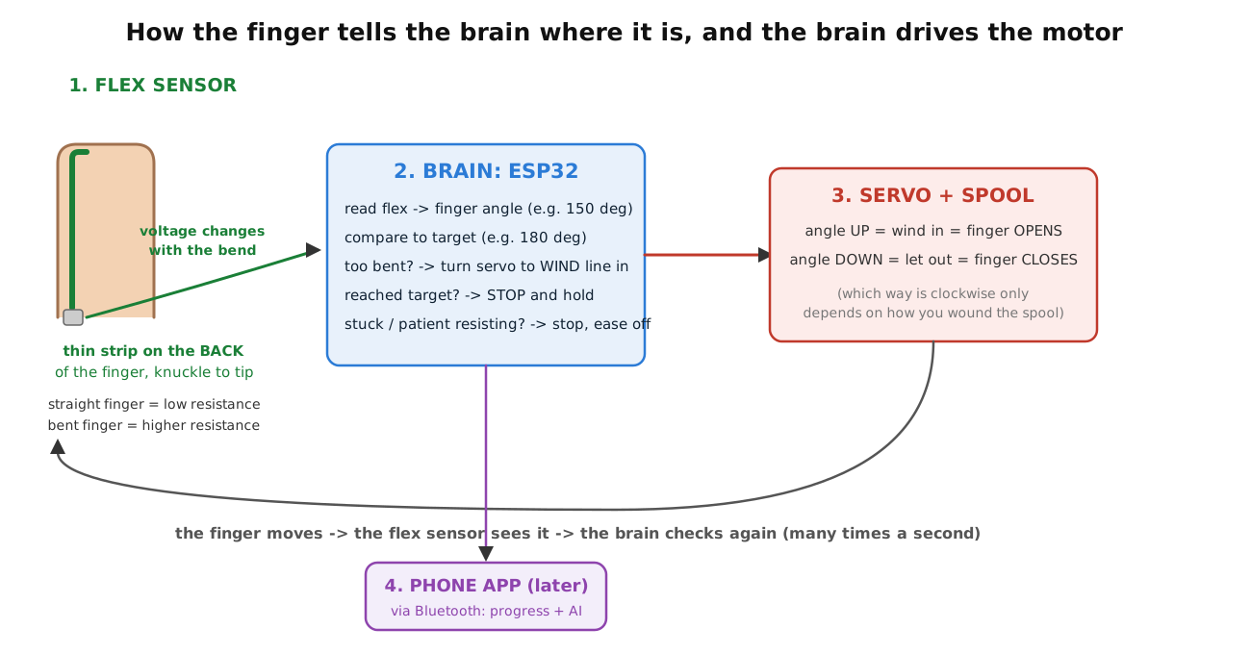
docs/wiring/flex_control_loop.png
