NattyBoppy/MDDSTROKE/docs/wiring/flex_sensor_wiring.png

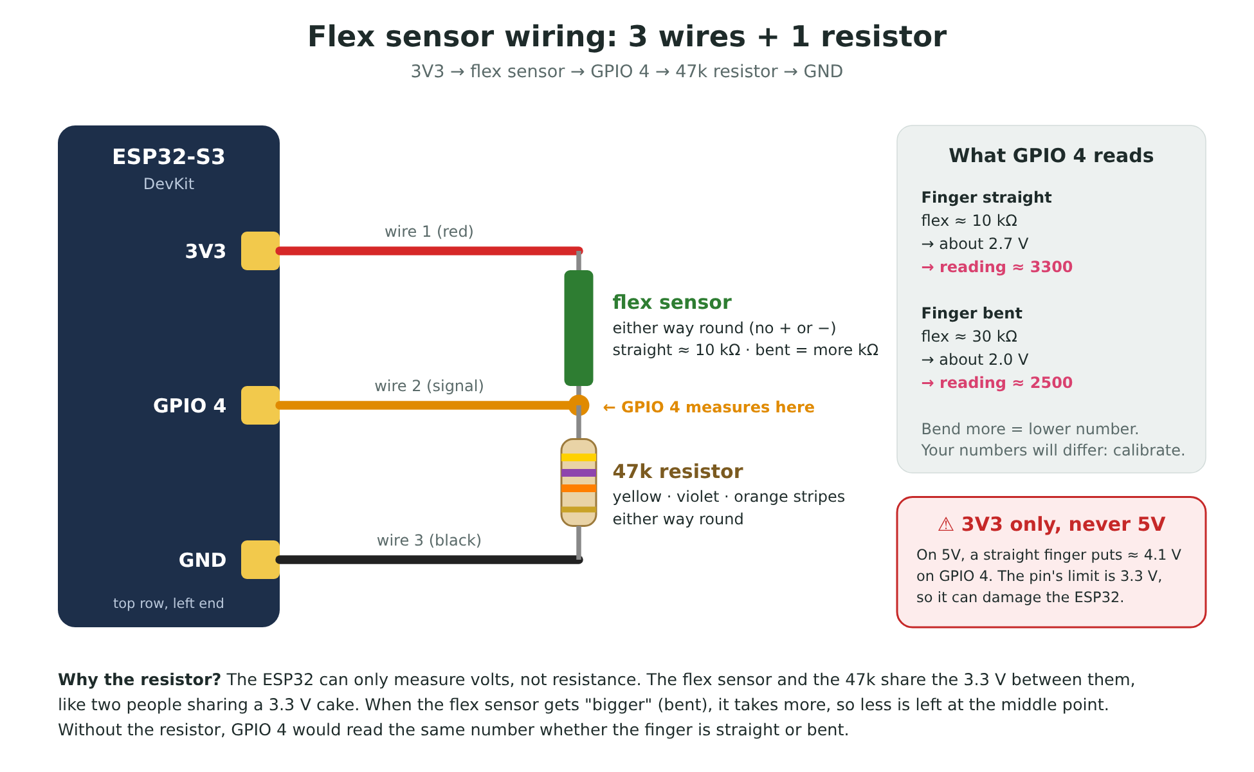
docs/wiring/flex_sensor_wiring.png
