NattyBoppy/MDDSTROKE/docs/wiring/flex_wiring.png

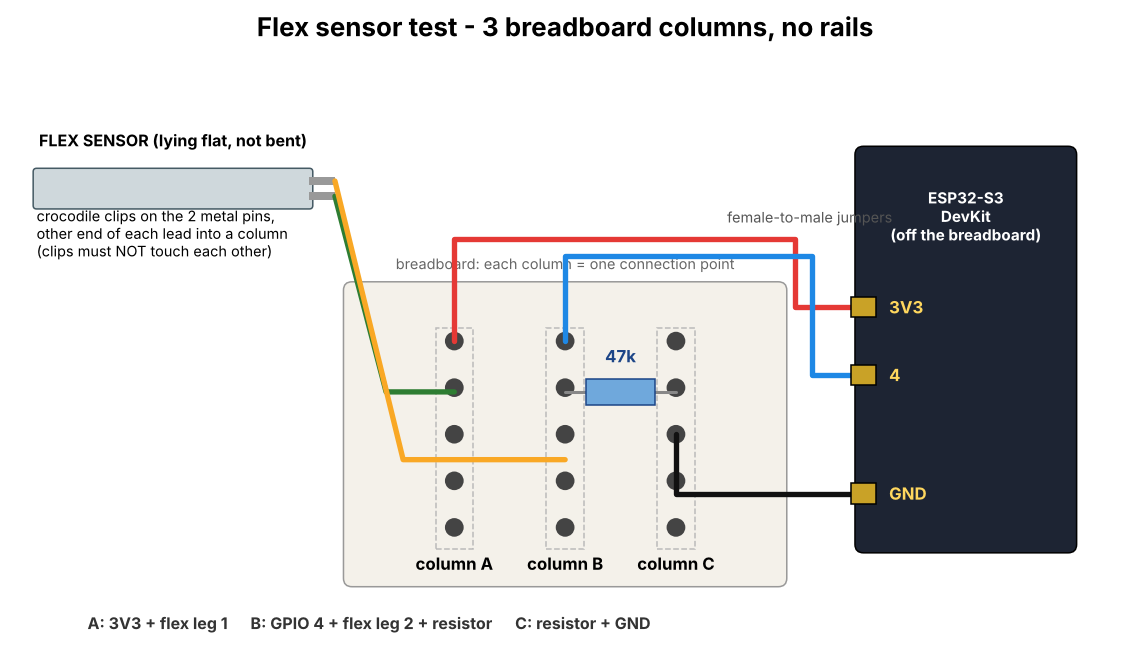
docs/wiring/flex_wiring.png
