NattyBoppy/MDDSTROKE/docs/wiring/mg996r_knob_wiring.png

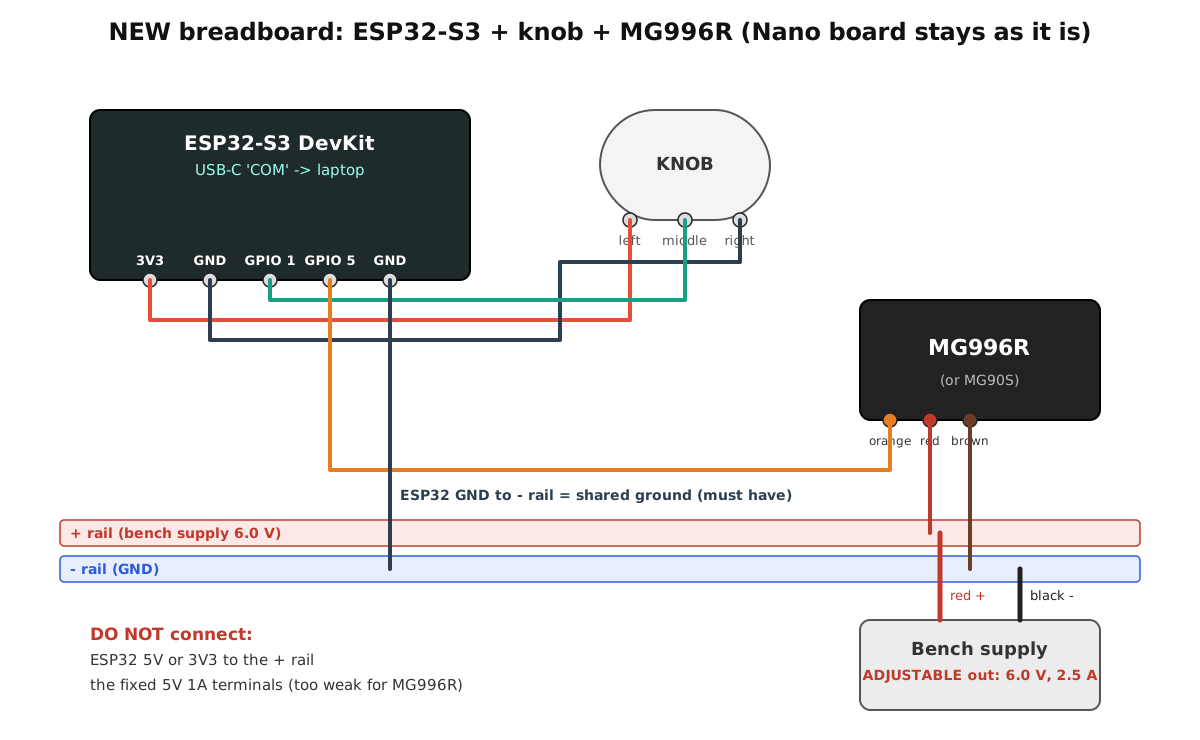
docs/wiring/mg996r_knob_wiring.png
