NattyBoppy/MDDSTROKE/docs/wiring/tinkercad_flex_layout.png

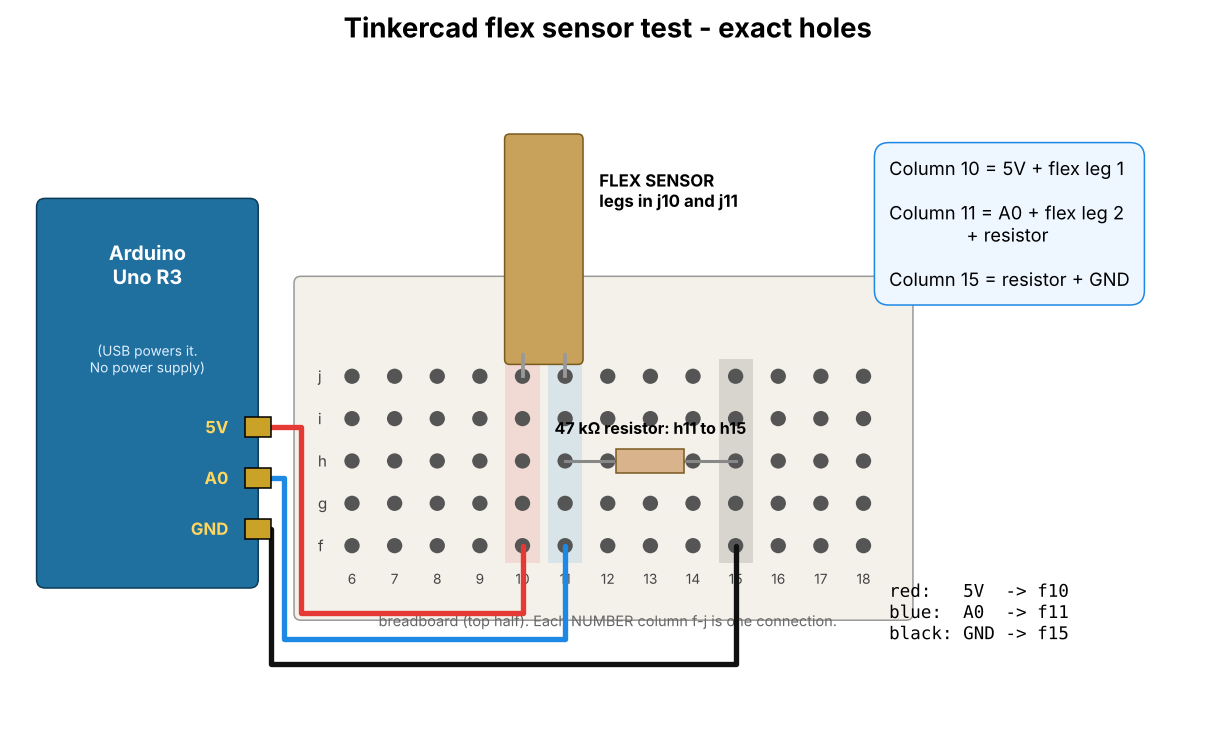
docs/wiring/tinkercad_flex_layout.png
