NattyBoppy/MDDSTROKE/(commit log)

2026-10-20 Add project files: website v1, firmware, STLs, diagrams, docs, progress log
    - website/v1: working three.js finger tracker (USB + Bluetooth)
    - firmware: flex (Nano/XIAO/DevKit), motor knob tests (MG996R, STS3215), EMG sketches
    - hardware: knuckle roller + anchor set, back-of-hand mount, spool v4 (STL + scripts)
    - docs: wiring diagrams, finger-wrap concepts A-E, previews, website v2 prompt
    - CLAUDE.md (project context + safety rules), SAFETY.md, PROGRESS_FARID.md
    Claude-Session: https://claude.ai/code/session_01GU1emP7q1Y5DSa3J6huN54
    [anchor_middle.stl, anchor_proximal.stl, hand_servo_mount.stl, knuckle_anchor_set_plate.stl, knuckle_clip.stl, knuckle_roller.stl, spool_r10_mg90s.stl, spool_v4_r10_for_hand_mount_trim_horn.stl]
2026-10-20 Website v2: protocol parser with unit tests
    Parses D/F/M/E lines, ignores garbage and ESP32 boot messages, joins
    lines split across chunks, and only allows o/c/s to be sent.
    Claude-Session: https://claude.ai/code/session_01DzdJ2GVwHnWSbc4bwTXLm9
2026-10-20 Website v2: realistic 3D hand dashboard
    Skinned WebXR hand with physical skin material, room lighting, soft
    shadows; per-finger natural bend with smoothing; USB, Bluetooth and demo;
    per-finger calibration with JSON export/import; big STOP (Space key);
    BLOCKED banner; 30 s charts and CSV recording; light/dark theme.
    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
2026-10-20 Firmware: multi_flex_devkit for up to 5 flex sensors over USB + BLE
    Sends F lines every 20 ms; FITTED[5] marks connected sensors (-1 if not).
    No motor: o/c/s are ignored.
    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
    [multi_flex_devkit.ino]
2026-10-20 Publish website/ to GitHub Pages; landing page links v1 and v2
    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
2026-10-21 Progress log 21 Oct: EMG fixed (ESP off breadboard), flex sensor tests
    - PROGRESS_FARID.md: lab session entry, status table and to-do updated
    - firmware/flex: flex_visual_test (auto-zoom bend %), tinkercad_uno_flex
    - docs/wiring: flex_wiring.png
    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
    [flex_visual_test.ino, tinkercad_uno_flex.ino]
2026-10-22 Add flex sensor wiring diagram (3V3, GPIO 4, 47k, GND)
    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
2026-10-22 Progress log 22 Oct: flex sensor + 5 LED bar graph on Arduino Uno
    - PROGRESS_FARID.md: test numbers (94k/10k/zoom), lessons, status + to-do
    - firmware/flex: flex_5led_uno (zoom, b/r calibration, hysteresis), ESP32 + Tinkercad versions
    - docs/wiring: ESP32 flex+LED wiring, Tinkercad flex layout
    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
    [flex_5led_esp32.ino, flex_5led_tinkercad_uno.ino, flex_5led_uno.ino]
2026-10-22 Website v2: warn when a flex reading is stuck at 0 V or 3.3 V
    A reading near 0 means the sensor is not connected to 3V3; near 4095
    means the 47k to GND is missing. Say so instead of showing a still hand.
    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
2026-10-23 Finger clamps v8: 12 TPU C-clamps, generator script, print + assembly README
    Claude-Session: https://claude.ai/code/session_01FyUVGmEqx1Gp7aeunuZ7my
    [ALL_12_print_plate_v8.stl, index_1_base_v8.stl, index_2_middle_v8.stl, index_3_tip_v8.stl, middle_1_base_v8.stl, middle_2_middle_v8.stl, middle_3_tip_v8.stl, pinky_1_base_v8.stl]
2026-10-23 Docs: 3D design pages (finger clamps, motor layout A vs B) and previews
    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
2026-10-23 README, CLAUDE.md, safety checks and progress log for 23 Oct (clamps v8, layout B)
    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
